nowae/libkicad/README.md

# libkicad
KiCad 4.0.x Library

KiCad 5.0.x Library

For drawing rules, read file [RULES.md](https://github.com/nowae/libkicad/blob/master/RULES.md)
