nowae/libkicad/RULES.md

# Drawing Rules for KiCad 5

## Symbol Editor

Symbol Name and Reference Field text size: 1.27 mm [50 mils]

Pin Lenght: 2.54 mm [100 mils]

Pin Name text size: 1.27 mm [50 mils]

Pin Number text size: 1.27 mm [50 mils]

Power Symbol text size: 1.016 mm [40 mils]

## Footprint Editor
Text Width: 0.8 mm

Text Height: 0.8 mm

Text Thickness: 0.15 mm

Line segment thickness: 0.15 mm
