nowae/libkicad/CONTENTS.md

Library
|-- Schematic
|   |-- Power
|   |   |-- +12V
|   |   |-- +24V
|   |   |-- +24VISO
|   |   |-- +24VISO1
|   |   |-- +24VISO2
|   |   |-- +3.3V
|   |   |-- +3.3VISO
|   |   |-- +5V
|   |   |-- +5VISO
|   |   |-- +5VISO1
|   |   |-- +5VISO2
|   |   |-- +5VISO3
|   |   |-- +V
|   |   |-- -5V
|   |   |-- GND
|   |   |-- GND-3V3-ISO
|   |   |-- GND-3V3-ISO1
|   |   |-- GND-3V3-ISO2
|   |   |-- GND-5V-ISO
|   |   |-- GND-5V-ISO1
|   |   |-- GND-5V-ISO2
|   |   |-- GND-5V-ISO3
|   |   |-- GND-EARTH
|   |   |-- GND-EARTH-1
|   |   |-- GND1
|   |   |-- GNDISO
|   |   |-- GNDISO1
|   |   |-- GNDISO2
|   |
|   |-- Analog
|   |   |-- LTC2622
|   |   |-- MAX31855
|   |
|   |-- Battery Charger
|   |   |-- LTC4067
|   |   |-- MCP73831
|   |
|   |-- Buzzer
|   |   |-- BUZZER
|   |   |-- PKLCS1212E4001-R1
|   |
|   |-- Capacitor
|   |   |-- CAPACITOR
|   |   |-- CAPACITOR_POL
|   |
|   |-- Connector
|   |   |-- CONN_12X1
|   |   |-- CONN_12X2
|   |   |-- CONN_2X1 
|   |   |-- CONN_3X1
|   |   |-- CONN_4X1
|   |   |-- CONN_5X2
|   |   |-- CONN_6X1
|   |   |-- CONN_8X1
|   |   |-- DB9
|   |   |-- MICROSD-MOLEX:473092651
|   |   |-- MICROUSB-629105150521
|   |   |-- USB_B_180-5787834-1
|   |   |-- XBEE-SOCKET
|   |
|   |-- Crystal
|   |   |-- 32768Hz_CM7V-T1A
|   |   |-- ABM7-12.000MHZ
|   |   |-- ABM7-16.000MHZ
|   |
|   |-- DcDc
|   |   |-- TEL3-2411
|   |   |-- TME2405S
|   |   |-- TES1-2411
|   |   |-- TSR0.5-2433
|   |   |-- TSR1-2433SM
|   |   |-- TSR1-2450SM
|   |   |-- TSRN1-2450SM
|   |
|   |-- Development Board
|   |   |-- XMC4700-RELAX
|   |
|   |-- Diode
|   |   |-- BYM10-1000
|   |   |-- CD0603-SO180R
|   |   |-- CDSOT23-SM712
|   |   |-- MBR0520
|   |   |-- MBRS2040L
|   |   |-- MMBD7000LT1G
|   |   |-- MMSZ4684T1G
|   |   |-- PESD12VL2BT
|   |   |-- PESD1CAN
|   |   |-- RS1M
|   |   |-- SK36A
|   |   |-- SM15T39CA
|   |   |-- SMBJ48A-13-F
|   |
|   |-- Fuse
|   |   |-- 0155003.DRT
|   |   |-- FUSE
|   |
|   |-- Inductor
|   |   |-- FERRITE_BEAD
|   |   |-- INDUCTOR
|   |   |-- TCK-044
|   |
|   |-- Led
|   |   |-- CLV1A-FKB (RGB)
|   |   |-- GREEN
|   |   |-- RED
|   |   |-- YELLOW
|   |
|   |-- Logic
|   |   |-- DRV8804DW
|   |   |-- DS3231
|   |   |-- SN65HVS882
|   |   |-- SN74LV14A
|   |   |-- VN808CM-E
|   |
|   |-- Microcontroller
|   |   |-- ATSAM3X8E
|   |   |-- MKL15Z128VLH4
|   |   |-- MK64FN1M0VDC12
|   |   |-- MK64FN1M0VLL12
|   |
|   |-- Miscellaneous
|   |   |-- AMCA31-2R450G-S1F-T (ANTENNA)
|   |   |-- SMALL_JUMPER
|   |   |-- SMALL_JUMPER_3
|   |   |-- TEST_POINT
|   |
|   |-- Operational Amplifier
|   |   |-- OPA2132U
|   |   |-- OPA2314
|   |   |-- SI8920BC-IP
|   |
|   |-- Optoisolator
|   |   |-- ISO7241M
|   |   |-- ISO7340FC
|   |   |-- ISO7341C
|   |   |-- ISO7341FC
|   |   |-- ISO7421
|   |
|   |-- Regulator
|   |   |-- MIC5205-3.3
|   |   |-- REF3312AIDB
|   |   |-- SPX3819-3.3
|   |
|   |-- Resistor
|   |   |-- 3224J-1-103E
|   |   |-- 3224J-1-104E
|   |   |-- CAT16-103J4LF
|   |   |-- CAT16-104J4LF
|   |   |-- MMA0204-1K2
|   |   |-- MMB0207-56
|   |   |-- RESISTOR
|   |   |-- VARISTANCE
|   |
|   |-- Sensor
|   |   |-- FXAS21002C
|   |   |-- FXOS8700CQ
|   |   |-- MMA8451Q
|   |   |-- MPL3115A2
|   |   |-- SFH5711
|   |   |-- Si7021-A20
|   |
|   |-- Switch
|   |   |-- EVQPE104K
|   |
|   |-- Transceiver
|   |   |-- FT230XS
|   |   |-- SN65HVD888
|   |   |-- TJF1051T
|   |   |-- TJF1052IT
|   |
|   |-- Transistor
|   |   |-- BCW66
|   |   |-- IRLML6402
|   |   |-- Si2333DDS
|   |   |-- ZVN4210G
|   |
|   |-- Wireless
|       |-- ZVN4210G
|
|-- Footprint
|   |-- BATTERY-HOLDERS
|   |   |-- KEYSTONE-1042P
|   |   |-- KEYSTONE-3002
|   | 
|   |-- BUZZER
|   |   |-- BUZZER-PKLCS-SERIES
|   |
|   |-- CAPACITOR
|   |   |-- CAPACITOR-6.3x5.3
|   |   |-- CAPACITOR-6.3x7.7
|   |   |-- CAPACITOR-8.0x6.2
|   |   |-- CAPACITOR-8.0x10.0
|   |   |-- CAPACITOR-0402
|   |   |-- CAPACITOR-0603
|   |   |-- CAPACITOR-0805
|   |   |-- CAPACITOR-1206
|   |
|   |-- CONNECTOR
|   |   |-- CONN-SOCKET-12x2-2.54
|   |   |-- CONN-STRIP-4x1-2.54
|   |   |-- CONN-STRIP-5x2-1.27-SMD
|   |   |-- CONN-XBEE-THT
|   |   |-- CONN-XBEEPRO-THT
|   |   |-- DB9_FEMALE_V
|   |   |-- DB9_MALE_V
|   |   |-- MICROUSB-WURTH-WRCOM
|   |   |-- SDCARD-MOLEX-0473092651
|   |   |-- USB-TECON-5787834_1
|   |
|   |-- CONNECTOR_MCV
|   |   |-- CONN-MCV0.5_3-G-2.5
|   |   |-- CONN-MCV0.5_4-G-2.5
|   |   |-- CONN-MCV0.5_8-G-2.5
|   |   |-- CONN-MCV0.5_12-G-2.5
|   |   |-- CONN-MCV1.5_3-G-3.81
|   |   |-- CONN-MCV1.5_4-G-3.81
|   |   |-- CONN-MCV1.5_8-G-3.81
|   |
|   |-- CRYSTAL
|   |   |-- CRYSTAL-1206
|   |   |-- CRYSTAL-ABM7
|   |
|   |-- DIODE
|   |   |-- DIODE-SOD123
|   |   |-- DIODE-DO214AA-UNI
|   |   |-- DIODE-DO214AB-BID
|   |   |-- DIODE-DO214AB-UNI
|   |   |-- DIODE-DO214AC-UNI
|   |
|   |-- DFN
|   |   |-- DFN6_3.0x3.0_1.0
|   |   |-- DFN12+1_3.0x4.0_0.5
|   |
|   |-- DIP
|   |   |-- DIP8-SMD
|   |
|   |-- FUSE
|   |   |-- FUSE-LITTELFUSE-SMT
|   |
|   |-- INDUCTOR
|   |   |-- INDUCTOR-0402
|   |   |-- INDUCTOR-0603
|   |   |-- INDUCTOR-0805
|   |   |-- INDUCTOR-TCK044
|   |
|   |-- LEDs
|   |   |-- LED-0402
|   |   |-- LED-0603
|   |   |-- LED-0805
|   |   |-- LED-1206
|   |
|   |-- LQFP
|   |   |-- LQFP64_10x10_0.5
|   |   |-- LQFP144_20x20_0.5
|   |
|   |-- MECHANICAL
|   |   |-- FIDUCIAL-TOP
|   |   |-- SCREW-M2
|   |   |-- SCREW-M2.5
|   |   |-- SCREW-M3
|   |   |-- SCREW-M4
|   |
|   |-- MISC
|   |   |-- JUMPERSMD-3
|   |   |-- SENSOR-SFH5711
|   |   |-- TESTPOINT-1MM
|   |
|   |-- RESISTOR
|   |   |-- RESISTOR-0402
|   |   |-- RESISTOR-0603
|   |   |-- RESISTOR-0805
|   |   |-- RESISTOR-1206
|   |   |-- RESISTOR-CAT16-X4
|   |   |-- RESISTOR-TRIM-BOURNS-3224J
|   |
|   |-- SOIC
|   |   |-- POWERSO-36_11.0x15.9_0.65
|   |   |-- SOIC8_3.9x4.9_1.27
|   |   |-- SOIC14_3.9x8.7_1.27
|   |   |-- WSOIC16_7.4x10.1_1.27
|   |
|   |-- SOT
|   |   |-- SOT23-3
|   |   |-- SOT23-3-GSD
|   |   |-- SOT23-5
|   |   |-- SOT223
|   |
|   |-- SSOP
|   |   |-- MSOP8_3x3_0.65
|   |   |-- SSOP16_3.9x4.9_0.635
|   |
|   |-- SWITCH
|   |   |-- SWITCH-EVQPE1
|   |
|   |-- TRACOPOWER
|   |   |-- TRACO-TES1-XXXX
|   |   |-- TRACO-TES3-XXXX
|   |   |-- TRACO-TSR0.5-24XX
|   |   |-- TRACO-TSRN1-XXXXSM
|   |
|   |-- WIFI
|   |   |-- ANTENNA-AMCA31
|   |   |-- WIFI-SPWF01XX
