nowae/libkicad/3dmodels/Download_STP_171960501 (rev1).stp

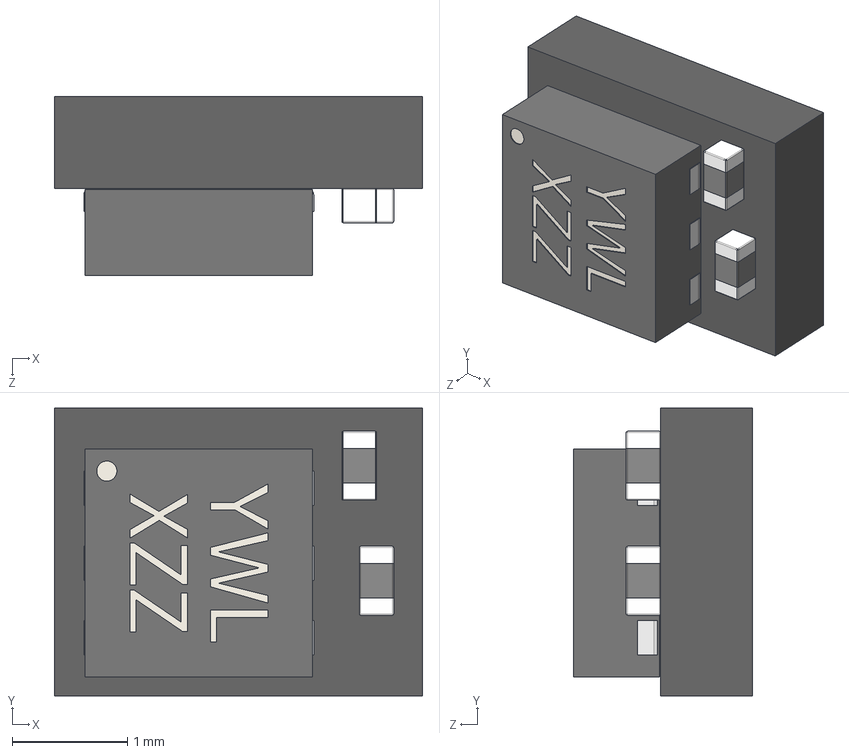
[picture p1: CAD file, 2023-07-04]
3dmodels/Download_STP_171960501 (rev1).stp
3.20 x 2.50 x 1.56 mm
contacts
substrate
contacts_2
QFNBODY
Ferrite x 2
