nowae/libkicad/(threads)

Thread 1 (2017-12-18):

Error in CAPACITOR 16.0x17.0

norlandini, 2017-12-18:
Pins on F.Fab to fix

Closed 2018-03-02.

Thread 2 (2017-12-21):

Error in CAPACITOR 10.0x10.5

norlandini, 2017-12-21:
Pins on F.Fab to fix

Closed 2018-03-02.

Thread 7 (2018-02-22):

The 3d doesn't match the real dimension

warcomeb, 2018-02-22:
https://github.com/nowae/libkicad/blob/67caa983c4b418fb2e63761aed015b6c25e33886/modules/RELAY.pretty/RELAY-JSSERIES-1FORMA.kicad_mod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

Thread 8 (2018-02-22):

The 3d doesn't match the real dimension or silkscreen is wrong

warcomeb, 2018-02-22:
https://github.com/nowae/libkicad/blob/67caa983c4b418fb2e63761aed015b6c25e33886/modules/RELAY.pretty/RELAY-JTNSERIES-1FORMA.kicad_mod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

Thread 11 (2018-03-06):

Missing 3d for RELAY-MEDER-KTXX1A40LTHT

norlandini, 2018-03-06:
Missing 3d models for RELAY-MEDER-KTXX1A40LTHT

Thread 12 (2018-03-06):

Missing 3d for RELAY-MEDER-KTXX1A40LSMD

norlandini, 2018-03-06:
Missing 3d models for RELAY-MEDER-KTXX1A40LSMD

Thread 14 (2018-06-04):

batterycharger/BQ24040DSQT footprint is wrong

norlandini, 2018-06-04:
Modified footprint association from SON:WSON10_3.0x3.0_0.5_10+1 to SON:WSON10_2.0x2.0_0.4_10+1

Closed 2018-06-04.

Thread 17 (2018-10-23):

Missing 3D models for RESISTOR-1210

norlandini, 2018-10-23:
https://github.com/nowae/libkicad/blob/60facbea3e09babe457bff9c9c2e3e7f0f719369/modules/RESISTOR.pretty/RESISTOR-1210.kicad_mod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

Closed 2018-11-08.

Thread 20 (2018-12-18):

Check Polarity-Key

warcomeb, 2018-12-18:
https://github.com/nowae/libkicad/blob/c752d6f76047a87e1d929d4be167aa1856e1990e/modules/CONNECTOR.pretty/M2_2230-TE-2199119-4.kicad_mod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

There are different polarity key for the same connector

warcomeb, 2018-12-18:
See: [datasheet](https://www.te.com/commerce/DocumentDelivery/DDEController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)
