nowae/libkicad/(commit log)

2016-09-15 Added some power symbols, added TJF1051T and TJF1052IT transceivers, added TSR1-2433SM dc-dc converter, added XBEE socket into connector library and added MMSZ4684T1G diode.
2016-09-17 Added MMA8451Q, SFH5711 and Si7021 sensor, added PESD1CAN diode and DB9 connector.
2016-09-17 Added DS3231 (RTC device) into logic library and BCW66 transistor.
2016-09-18 Added 3224J-1-103E and 3224J-1-104E trimmer, added REF3312 voltage reference, added TES3-2422 DC/DC converter, added LM358 operational amplifier and added some power supply labels.
2016-10-02 Added MCP73831 battery charger; added CONN_12x2, MICROSD-MOLEX:473092651 and USB_B_180-5787834-1 connector; added ABM7-12.000MHZ crystal; added TES1-2411 and TSR0.5-2433 DC/DC converter; added MBRS20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
2016-10-08 Added capacitor footprint 0402, 0603, 0805 and 1206.
2016-10-08 Added resistor footprint 0402, 0603, 0805 and 1206.
2016-10-08 Added leds footprint 0402, 0603, 0805 and 1206.
2016-10-08 Added diode footprint SOD123
2016-10-08 Added SOIC footprint library with SOIC14_3.9x8.7_1.27
2016-10-08 Added WSOIC16_7.4x10.1_1.27 footprint into SOIC library
2016-10-09 Added footprint library CONNECTOR_MCV with CONN-MCV1.5_3-G-3.81 and CONN-MCV1.5_8-G-3.81
2016-10-12 Added TRACOPOWER library with TRACO-TSR0.5-24XX footprint
2016-10-13 Small fix on footprint for MCV connector
2016-10-13 Added footprint for DO214AB packages for unidirectional and bidirectional diodes
2016-10-17 Added DIP footprint library with DIP8-SMD
2016-10-18 Added POWERS0-36_11.0x15.9_0.65 footprint into SOIC library.
2016-10-18 Added CAPACITOR-6.3x7.7 and CAPACITOR-8.0x6.2 into CAPACITOR library.
2016-10-19 Created inductor footprint library with INDUCTOR-TCK044
2016-10-20 Added SOIC8_3.9x4.9_1.27 footprint
2016-10-20 Added SOT footprint library with SOT23-3 and SOT23-3-GSD
2016-10-20 Added SSOP footprint library with SSOP16_3.9x4.9_0.635
2016-10-21 Added CONN-MCV0.5_3-G-2.5 e CONN-MCV0.5_8-G-2.5 footprint
2016-10-22 Added DIODE-SMB footprint
2016-10-22 Added SOT23-5 and SOT223 footprint into SOT library
2016-10-22 Added CONN-5x2-1.27-SMD footprint into CONNECTOR library
2016-10-22 Changed DIODE-SMB footprint in DIODE-DO214AA-UNI
2016-10-22 Added LQFP footprint library with LQFP64_10x10_0.5 and LQFP144_20x20_0.5
2016-10-22 Added CRYSTAL footprint library with CRYSTAL-1206 and CRYSTAL-ABM7
2016-10-22 Added RESISTOR-TRIM-BOURNS-3224J footprint
2016-10-22 Added MSOP8_3x3_0.65 footprint
2016-10-22 Added QFN footprint library with QFN16_3x3_0.5 and QFN16_3x3_0.5_5+3
2016-10-22 Added DFN footprint library with DFN6_3.0x3.0_1.0 and DFN12+1_3.0x4.0_0.5
2016-10-24 Updated DB9 MALE connector and added DB9 FEMALE connector. Added DB9_FEMALE_V and DB9_MALE_V footprints in CONNECTOR library.
2016-10-24 Updated description of DB9_FEMALE and DB9_MALE connectors.
2016-11-05 Fixed VN808CM-E pin into schematich library: 0 pin changed to TAB.
2016-11-05 Fixed silksreen into POWERSO-36_11.0x15.9_0.65 component
2016-11-05 Fixed pin of MMBD7000LT1G schematich component
2016-11-05 Fixed borderline of DIODE-SOD123 footprint
2016-11-07 Fixed silkscreen dimension: from 0.2 to 0.15
2016-11-12 Added CONN-MCV0.5_12-G-2.5 footprint
2016-11-12 Added CONN-XBEE-THT and CONN-XBEEPRO-THT footprint into CONNECTOR library
2016-11-12 Added MISC library with JUMPERSMD-3 footprint
2016-11-12 Added TESTPOINT-1MM (example distributor code is RS:262-2179) footprint into MISC library
2016-11-12 Added CONN-MCV0.5_4-G-2.5 footprint into CONNECTOR_MCV library
2016-11-12 Added BUZZER footprint library with BUZZER-PKLCS-SERIES
2016-11-12 Added SENSOR-SFH5711 footprint into MISC library. Right now there isn't a better place.
2016-11-12 Added TRACO-TES3-XXXX footprint into TRACOPOWER library
2016-11-13 Removed hole from footprint: isnt't usefull for the assembling
2016-11-13 Added TRACO-TES1-XXXX footprint into TRACOPOWER library
2016-11-13 Added MICROUSB (WURTH) and USB type B vertical (TE CONNECTIVITY) connector footprint
2016-11-13 Added silkscreen
2016-11-14 Added TRACO-TSRN1-XXXXSM footprint into TRACOPOWER library
2016-11-14 Added JUMPERSMD-2 footprint into MISC library
2016-11-15 Added SK36A schematich components
2016-11-15 Added DIODE-DO214AC-UNI footprint into DIODE library
2016-11-15 Removed wrong named footprint
2016-11-15 Added M2, M2.5 and M3 screws in MECHANICAL.pretty.
2016-11-16 Added CONN-12x2-2.54-BERG footprint into CONNECTOR library
2016-11-16 Added FUSE footprint library with FUSE-LITTELFUSE-SMT
2016-11-16 Added footprint CAPACITOR-8.0x10.0: doesn't change anything compared to 8.0x6.2, only the 3D model for the height.
2016-11-16 Added CONN-MCV1.5_4-G-3.81 footprint into CONNECTOR_MCV library
2016-11-17 Created BATTERY-HOLDERS footprints library with KEYSTONE-3002 and added 3D model for this footprint
2016-11-17 Added SCREW-M4 footprint into MECHANICAL library
2016-11-17 Added 3D model for connector 12x2 socket
2016-11-17 Added resistor pack RESISTOR-CAT16-X4 footprint into RESISTOR library with 3D models
2016-11-17 Added footprint CAPACITOR-6.3x5.3: doesn't change anything compared to 6.3x7.7, only the 3D model for the height.
2016-11-17 Added 3D models for the capacitors added before
2016-11-17 Added INDUCTOR-0402, INDUCTOR-0603 and INDUCTOR-0805 footprint
2016-11-17 Added SWITCH footprint library with SWITCH-EVQPE1
2016-11-17 Changed name of CONN-12x2-2.54-BERG footprint to CONN-SOKET-12x2-2.54
2016-11-17 Changed name of CONN-5x2-1.27-SMD footprint to CONN-STRIP-5x2-1.27-SMD
2016-11-17 Added CONN-STRIP-4x1-2.54 footprint into CONNECTOR library
2016-11-17 Some fix on CONN-STRIP-5x2-1.27-SMD footprint
2016-11-17 Fix pin number on MCP73831
2016-11-17 Added SDCARD-MOLEX-0473092651 footprint into CONNECTOR library
2016-11-17 Added 3D model for screw
2016-11-18 Added KEYSTONE-1042P footprint into BATTERY-HOLDERS library
2016-11-18 Added FIDUCIAL-TOP footprint into MECHANICAL library
2016-12-09 Fix footprint: deleted extra lines
2016-12-09 Fix footprint: added silkscreen line for first pin
2016-12-15 Added WIFI footprint library with ANTENNA-AMCA31 and WIFI-SPWF01XX
2016-12-15 Added MK64FN1M0VLL12 schematic coomponent
2016-12-17 Added RN4870 in schematic component (wireless.lib).
2016-12-19 Added MK64FN1M0VDC12 schematich component into microcontroller library
2016-12-20 Added MAPBGA121 footprint into BGA library (new library) with 3D model
2017-01-22 Added LMZ34002, LMZ35003 and TPS62180 in switching library (ohilab-switching).
2017-01-23 Added TPS62743 in switching library.
2017-01-31 Renamed all files of schematich library
2017-01-31 Changed defined KIOHILABMOD to KINOWAEMOD into footprint where 3D model is selected
2017-02-10 Centered value of RESISTOR symbol
2017-02-12 Added USB_A_90 in connectors library
2017-02-12 Added blue led on led library
2017-02-12 Created nowae-driver library and added TPS92511 and FLS0116
2017-02-12 Added US1M in diodes library
2017-02-21 Added FRDM-KL25Z development board
2017-02-21 Moved VCCIO pin of FT230XS into better position
2017-02-25 Removed footprints filter in nowae-capacitor.lib
2017-02-25 Removed resistor footprint filter in nowae-resistor.lib
2017-02-25 Added footprints filter in nowae-capacitor.lib
2017-02-25 Added resistor footprint filter in nowae-resistor.lib
2017-02-25 Added footprint filter for FT230XQ in nowae-transceiver.lib
2017-02-25 Added footprint filter in TPS62743
2017-02-25 Added footprint filter for IRLML6402 in nowae-transistor.lib
2017-02-25 Added footprint filter of inductance in nowae-inductor.lib
2017-03-01 Small fix for FRDM-KL25Z schematich component
2017-03-01 Added TPS62153 schematich component into switching library
2017-03-01 Added MKDS1_2-3.81 footprint into new library CONNECTOR_MKDS
2017-03-01 Added 3D model for footprint CONN-MKDS1_2-3.81
2017-03-01 Fix on footprint filters os some schematich components
2017-03-01 Added CONN-1x1 schematich component
2017-03-03 Added CONN-FRDM footprint into CONNECTOR library. It is useful when in the board is present a NXP freedom board.
2017-03-06 Added TPS62152 in nowae-switching.lib
2017-03-06 Added USB A plug smd in connector.pretty
2017-03-06 Added pin 17 (exposed thermal pad) in TPS62153. Added footprint filter
2017-03-06 Added TDK SPM3012 Inductor footprint
2017-03-08 Added component reference into FAB layer for QFN16_3x3_0.5_16+1 footprint
2017-03-08 Added component reference into FAB layer for JUMPERSMD-2 and JUMPERSMD-3 footprint
2017-03-08 Updated footprint filter for FT230X-S
2017-03-09 Added description and footprint filter for RN4870 in nowae-wireless.lib Added nowae-wireless.dcm
2017-03-22 Added MKDS1_4-3.81 footprint into library CONNECTOR_MKDS
2017-04-10 Fixed package filter of FT230X in nowae-transceiver.lib
2017-04-13 Added reference (pin 1) in QFN16_3x3_0.5_16+1 in QFN.pretty
2017-04-13 Modified 3D model in CONN-MKDS1_4-3.81 in CONNECTOR_MKDS.pretty
2017-04-13 Added pin 32-33 in RN4870U in WIFI.pretty
2017-04-15 Added logo in nowae.kicad_wks
2017-05-24 Added GND-24V-ISO in power.lib. Added description of GND-24V-ISO in power.dcm.
2017-05-29 Modified REF3312 in nowae-regulator.lib
2017-05-29 Added schematic library for relay, with IM07TS of TE Connectivity.
2017-05-30 Updated pin dimension of IM07TS relay
2017-06-05 Added schematic symbols for ULN2803ADW and TPL7407LD into transistor library
2017-06-05 Added schematic symbol for SN74LVC16373ADGGR into logic library
2017-06-09 Added schematic symbols for Harting connector 09031646921, Ethernet connector RB1-125BAG1A form WIZnet
2017-06-09 Added schematic symbols for resistor pack of 1.5kohm and 33ohm
2017-06-09 Added schematic symbols for KSZ8081RNACA of Microchip into transceiver library
2017-06-09 Added schematic symbol for ABM7-25.000MHZ into crystal library
2017-06-13 Added schematic symbols for MK64FN1M0VLQ12 of NXP into microcontroller library
2017-06-13 Added schematic symbol for 3-input AND SN74LVC1G11DBV into logic library
2017-06-13 Added schematic symbol for 4 vie dip-switch MCDHN-04F of multicomp
2017-06-26 Added DIODE-DO41 in DIODE.pretty with 3d model
2017-06-26 Added -5VISO and -3.3VISO in power.lib
2017-06-26 Modified text of GND-5V-ISO (+5V ISO -> 05V ISO) in power.lib
2017-07-03 Removed power supply in LM358 (part b) in nowae-opamp.lib
2017-07-19 Added REF3325 in nowae-regulator.lib with description in nowae-regulator.dcm
2017-07-21 Fixed LM358 in nowae-opamp (removed power supply from unit b)
2017-07-24 Added FXLN8372Q in nowae-sensor.lib with description in nowae-sensor.dcm
2017-07-31 Added ES1CL in nowae-diode.lib and description in nowae-diode.dcm
2017-07-31 Added voltage reference REF1930 in nowae-regulator.lib and description in nowae-regulator.dcm
2017-07-31 Added 03V3, 012V and 024V signals in power.lib
2017-08-02 Added SN6505BDBVT schematich component into regulator library
2017-08-02 Added micro SD connector 693071010811 of wurth elektronik into connector library.
2017-08-02 Added diode 1N5819 into nowae-diode.lib. Added description into nowae-diode.dcm.
2017-08-02 Updated 1N5819HW-7-F in nowae-diode.lib
2017-08-02 Added ST1S14PHR into nowae-switching.lib. Added description into nowae-switching.dcm.
2017-08-03 Added schematich component BAV70L into nowae-diode.lib
2017-08-03 Added schematich component MCDHN-08F into switch library
2017-08-03 Added schematich component SN74LVC1G332BVD into logic library
2017-08-03 Added schematich component TS3A4741DGKR into switch library: is an analog switch.
2017-08-03 Added footprint HSOIC8_3.9x4.9_1.27 into SOIC.pretty
2017-08-03 Added footprint SOT23-6 in SOT.pretty with 3d model
2017-08-04 Added schematich component CURRENTTRANSFORMER-TALEMA:AC1200 into inductor library
2017-08-04 Added footprint TQFN20_5x5_0.65_20+1 into QFN.pretty with 3d model (qfn-20)
2017-08-04 Added footprint filter for MAX31865 in nowae-analog.lib
2017-08-05 Added footprint QFN12_3x3_0.65 in QFN.pretty
2017-08-05 Modified footprint filter for INA333 into nowae-opamp.lib
2017-08-05 Added footprint filter for ST1S14PHR into nowae-switching.lib
2017-08-05 Added footprint filter for SN6505BDBVT into nowae-regulator.lib
2017-08-05 Added footprint filter for REF1930 into nowae-regulator.lib
2017-08-05 Added footprint filter for LM358 in nowae-opamp.lib
2017-08-05 Added footprint filter for FXLN8372QR1 in nowae-sensor.lib
2017-08-05 Added RMB4S into nowae-diode.lib
2017-08-05 Added footprint DIODE-TO269AA into DIODE.pretty
2017-08-06 Added footprint for TJF1052IT into nowae-transceiver.lib
2017-08-06 Fixed footprint for ST1S14PHR and TPS62152 into nowae-switching.lib
2017-08-06 Fixed footprint for INA333 into nowae-opamp.lib
2017-08-06 Fixed footprint for RMB4S into nowae-diode.lib
2017-08-06 Added description for RMB4S into nowae-diode.dcm
2017-08-06 Added footprint INDUCTOR-7050 into INDUCTOR.pretty
2017-08-06 Added footprint TRANSFORMER-750315371 into INDUCTOR.pretty
2017-08-06 Added footprint TRANSFORMER-AC1200 into INDUCTOR.pretty
2017-08-06 Added footprint information for CURRENTTRANSFORMER-TALEMA:AC1200 into nowae-inductor.lib
2017-08-06 Added footprint CAPACITOR-5.0x5.5 in CAPACITOR.pretty
2017-08-07 Renamed TRANSFORMER-AC1200 in CURRENTTRANSFORMER-AC1200 into INDUCTOR.pretty
2017-08-07 Added footprint information for LM358D in nowae-opamp.lib
2017-08-07 Added footprint DIODE-0603 in DIODE.pretty
2017-08-07 Added footprint SDCARD-WURTH-693071010811 in CONNECTOR.pretty
2017-08-07 Fixed CAPACITOR-5.0x5.5 into CAPACITOR.pretty
2017-08-07 Fixed CURRENTTRANSFORMER-AC1200 into INDUCTOR.pretty
2017-08-07 Fixed SDCARD-WURTH-693071010811 into CONNECTOR.pretty
2017-08-07 Added footprint CONN-STRIP-2x1-2.54 into CONNECTOR.pretty
2017-08-07 Added footprint CONN-STRIP-3x1-2.54 into CONNECTOR.pretty
2017-08-07 Added footprint LQFP100_14x14_0.5_100+1 in LQFP.pretty
2017-08-07 Fixed footprint information in XMC4500-F100x1024 into nowae-microcontroller.lib
2017-08-08 Added schematich symbol for CAT16-102J4LF component
2017-08-08 Added schematich component for SN74LVC1G04DBV, SN74LVC1G08DBV and VN330SP-E into logic library.
2017-08-08 Added schematich component for MMSZ4689T1G into diode library
2017-08-08 Added schematich component for ETH-WURTH:74990101210 into connector library
2017-08-09 Associated 3d model for CONN-STRIP-2x1-2.54 in CONNECTOR.pretty
2017-08-09 Added connector 20x2
2017-08-09 Added schematich component CONN_HARTING:09051486921 into connector library
2017-08-10 Added schematich component SMBJ100CA into diode library
2017-08-10 Added schematich components TLV2316IDGK and TLV316IDBV into opamp library
2017-08-10 Added schematich component TLV2316IDR into opamp library (this component is different from the previous commit because the footprint change)
2017-08-11 Added schematich components CONN_15x2, CONN_30x1 and DB44_MALE_90-TECONN:5749771-1 into connector library
2017-08-11 Added schematich components for TS4148-RYG into diode library and NE555D into logic library
2017-08-11 Added footprint VSSOP8_3x3_0.65 in SOP.pretty with 3d model
2017-08-11 Added 3d model for TESTPOINT-1MM into MISC.pretty
2017-08-11 Modified footprint for INA333 into nowae-opamp.lib
2017-08-11 Added schematich components TPS60400DBV and TPS79718DCK into regulator library
2017-08-11 Fixed GND-3V3-ISO and GND-5V-ISO into power.lib
2017-08-12 Fixed information on RMB4S into diode library
2017-08-13 Added schematich component for ESD8V0L2B-03L into diode library, but it is discontinued
2017-08-14 Added schematich component for TSR1-2450 into DC-DC library
2017-08-15 Added 3d model for DIODE-TO269AA into DIODE.pretty
2017-08-15 Added footprint KEYSTONE-3001 with 3d model into BATTERY-HOLDERS.pretty
2017-08-15 Added pin 21 for MAX31865 in nowae-analog.lib
2017-08-15 Added footprint for BREAKOUT-LINE in MECHANICAL.pretty
2017-08-22 Updated footprint QFN16_3x3_0.5_16+1 into QFN.pretty (increased via dimensions)
2017-08-22 Updated footprint KEYSTONE-3001 into BATTERY-HOLDERS.pretty
2017-08-22 Added footprint HOLE-M2 into MECHANICAL.pretty
2017-08-22 Added generic footprint CURRENT-TRASFORMER-AC1xxx into INDUCTOR.pretty
2017-08-22 Added footprint filter
2017-08-22 Added POWERSO-10_7.5x9.4_1.27 into SOIC.pretty
2017-08-23 Added footprint SC70-6 into SC70.pretty with 3d model
2017-08-23 Added schematich symbols for MBRA340T3G and BZG03C30TR into diode library, and COMMONMODEFILTER-WURTH:744282100 into inductor library
2017-08-24 Added schematich symbols STM1816TWX7F into logic library and TPS54232D into switching library
2017-08-24 Added schematich symbols for TPS54160ADGQ into switching library and ES2C, SS26FL into diode library
2017-08-24 Added relay footprint library with IM07TS footprint and 3D model
2017-08-25 Added SOIC16_3.9x9.9_1.27 footprint into SOIC library
2017-08-25 Added 3D model for LQFP144 footprint
2017-08-25 Added schematich symbol NC7WZ14EP6X into logic library
2017-08-25 Added schematich symbol for TPL7407LPW into transistor library
2017-08-25 Added footprints for TSSOP48 and TSSOP16 with 3D models
2017-08-29 Added 5x1 connector
2017-08-29 Added schematich symbol for PESD3V3L2BT into diode library, TLV2172IDR into opamp library and REF1933AIDD into regulator library
2017-08-30 Added schematich symbol for TPS61041DBVR into switching library
2017-09-01 Added footprint for MCV1.5_2-G-3.81 and MCV1.5_5-G-3.81 in CONNECTOR.MCV.pretty
2017-09-02 Added footprint TRACO-TEL3-XXXX in TRACOPOWER.pretty
2017-09-04 Added +13VISO and +14VISO power symbols
2017-09-05 Added 3d models (from wurth elektronik web site) for MCV1.5 series connector footprint
2017-09-05 Added 3d model for Wurth 693071010811 SDCard connector
2017-09-05 Added foorprint filter for ES2C symbol
2017-09-05 Added footprint for TRACO-TSR1 component with 3d model
2017-09-05 Added footprint for Wurth USB Connector, model 61400413321, with 3d model
2017-09-05 Fixed TRACO-TEL3-XXXX footprint and added 3d model
2017-09-05 Added footprints MSOP10_3x3_0.5 and MSOP10_3x3_0.5_10+1 with 3d model into SOP.pretty
2017-09-06 Added footprint for Wurth connector 687330124422 with 3d model
2017-09-06 Added schematich symbol for SMD dip switch 416131160808 by wurth and added footprint and 3d model for this component, added footprint and 3d model for smd dip switch 8p of omron A6H-810x or multicomp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
2017-09-07 Fixed assembly line of footprint
2017-09-07 Added CAPACITOR-12.5x14.0 with 3d model into CAPACITOR.pretty
2017-09-07 Added CAPACITOR-10.0x10.5 with 3d model into CAPACITOR.pretty
2017-09-08 Added footprint for DIODE-DO214AA-BID into diode library
2017-09-08 Added footprint and 3d model for lightpipe from Dialight (PN: 5151049F) into mechanical library
2017-09-08 Added footprint and 3d model of DSUB 44p from TE (PN: 5749771-1) into CONNECTOR_DSUB library
2017-09-11 Fixed holes dimension
2017-09-11 Added footprint and 3d model of Harting connector 09031646921
2017-09-13 Fixed SN6505 into nowae-regulator.lib
2017-09-15 Fixed pin numer
2017-09-16 Fixed MICROSD-WURTH:693071010811 into nowae-connector.lib
2017-09-19 Fixed footprint SDCARD-WURTH-693071010811 into CONNECTOR.pretty
2017-09-22 Added description of -5VISO into power.dcm
2017-09-23 Added schematich symbol TEN3-2411N into dc-dc library
2017-09-23 Added footprint TRACO-TEN3N-XXXX
2017-09-26 Added footprint USB-A-WURTH-614004135023 into CONNECTOR.pretty with 3d model
2017-09-26 Added footprint TESTPOINT-1MM-SMD into MISC.pretty
2017-09-26 Modified pin 1 of USB-A-WURTH-614004135023 into CONNECTOR.pretty
2017-09-26 Added footprint USB-A-WURTH-61400416021 into CONNECTOR.pretty with 3d model
2017-09-26 Added schematich symbol for CONN_14x1 into connector library
2017-09-27 Added footprint INDUCTOR-WURTH-1210 into INDUCTOR.pretty with 3d model
2017-09-27 Fixed footprint USB-A-WURTH-61400416021 into CONNECTOR.pretty
2017-09-27 Fixed footprint USB-A-WURTH-614004135023 into CONNECTOR.pretty
2017-09-27 Added schematic symbol USB_A-180-WURTH:614004135023 into nowae-connector.lib with description
2017-09-28 Removed 3d model for TESTPOINT-1MM-SMD into MISC.pretty
2017-09-30 Removed solderpaste layer from TESTPOINT-1MM-SMD into MISC.pretty
2017-09-30 Added 3d model for footprint SOP4_7.5x4.1_2.54 into SOP.pretty
2017-10-01 Added BQ24072 into nowae-batterycharger with description
2017-10-03 Added BQ25100 into nowae-batterycharger.lib with description
2017-10-04 Added footprint INDUCTOR-WURTH-1030 into INDUCTOR.pretty with 3d model
2017-10-09 Added schematich symbol for FXLS8471Q into sensor library
2017-10-11 Added schematich symbol for ORG1410-PM04 and ORG1510-R02 GPS modules into wireless library
2017-10-12 Added footprint CAPACITOR-16.0x17.0 into CAPACITOR.pretty with 3d model
2017-10-12 Added footprint DPAK-2 into PAK.pretty with 3d model
2017-10-12 Added footprint DPAK-5 into PAK.pretty with 3d model
2017-10-12 Added schematich symbol for BGM111A256V2 into wireless library.
2017-10-14 Fixed footprint DIODE-TO269AA into DIODE.pretty
2017-10-17 Added footprint SSOP4_4.4x2.6_1.27 into SOP.pretty with 3d model
2017-10-17 Fixed footprint SSOP4_4.4x2.6_1.27 into SOP.pretty
2017-10-19 Added symbol HOLE-M3 into MECHANICAL.pretty
2017-10-20 Updated 3d model of ZIF-WURTH-687330124422 into CONNECTOR-ZIF.pretty
2017-10-22 Added CONNECTOR_40X2 into nowae-connector.lib with description
2017-10-24 Added footprint USB-3.0-A-WURTH-692141030100 into CONNECTOR.pretty with 3d model
2017-10-24 Added connector USB-3.0-A-WURTH-692141030100 into nowae-connector.lib with description
2017-10-24 Added schematics symbols for: - WURTH HDMI connector inside connector library - PCA9306 and 74AVC1T45GW into logic library - PTN3363 into tranceiver library
2017-10-25 Added footprint CONN-S3053-V-2-3.81 into CONNECTOR_WR-TBL.pretty with 3d model
2017-10-25 Added footprint CONN-S3053-V-3-3.81 into CONNECTOR_WR-TBL.pretty with 3d model
2017-10-25 Added footprint CONN-S3053-V-4-3.81 into CONNECTOR_WR-TBL.pretty with 3d model
2017-10-25 Added footprint CONN-S3053-V-5-3.81 into CONNECTOR_WR-TBL.pretty with 3d model
2017-10-25 Added footprint CONN-S3053-V-6-3.81 into CONNECTOR_WR-TBL.pretty with 3d model
2017-10-25 Added footprint CONN-S3053-V-7-3.81 into CONNECTOR_WR-TBL.pretty with 3d model
2017-10-25 Added footprint CONN-S3053-V-8-3.81 into CONNECTOR_WR-TBL.pretty with 3d model
2017-10-25 Added footprint CONN-S3053-V-12-3.81 into CONNECTOR_WR-TBL.pretty with 3d model
2017-10-27 Added footprint ETHERNET-WURTH-615008140421 into CONNECTOR.pretty with 3d model
2017-10-28 Added schematich symbol for MKL25Z128VLH4 into microcontroller library
2017-10-31 Added symbols +1.8VA, +1.8VS, +3.3VA and +3.3VS into power.lib with descriptions
2017-10-31 Added symbol TPS22918 into nowae-switch.lib with description
2017-10-31 Added symbols M.2_2230 and M.2_2242 into nowae-connector.lib with descriptions
2017-11-05 Added TPS54541DPRT into nowae-switching.lib with description
2017-11-08 Added footprint DIPSWITCH-4P-WURTH-416131160804 into SWITCH.pretty with 3d model
2017-11-08 Updated footprint CAPACITOR-0603 into CAPACITOR.pretty
2017-11-08 Updated footprint RESISTOR-0603 into RESISTOR.pretty
2017-11-09 Modified footprint POWERSO-36_11.0x15.9_0.65 into SOIC.pretty. Added 3d model.
2017-11-10 Added symbol CONN_4x2 into nowae-connector.lib with description
2017-11-10 Updated footprint MICROUSB-WURTH-WRCOM into CONNECTOR.pretty. Added 3d model.
2017-11-14 Added symbol barrel jack into nowae-connector.lib with description
2017-11-14 Added symbol SS22 into nowae-diode.lib with description
2017-11-14 Fixed SS22 description into nowae-diode.dcm
2017-11-14 Fixed symbol barrel jack into nowae-connector.lib
2017-11-14 Added symbol TPS61087 into nowae-switching.lib with description
2017-11-14 Added schematich symbol for Wurth ethernet connector 7499511440 into connector library
2017-11-16 Added schematich symbol for TSR1-2433 into dc-dc library
2017-11-16 Added schematich symbol for MK10DX64VLH7 into microcontroller library
2017-11-16 Added some power symbols and 0154375.DRT symbol into fuse library
2017-11-16 Added schematich symbol for L78L12ACU into regulator library
2017-11-18 Added schematich symbol for PEM3012 into transceiver library
2017-11-18 Added schematich symbol TCMT1100 into opto library
2017-11-18 Added shematich symbol for REF3320AIDB, TLV70233DBV and TLV74333PDBVR into regulator library
2017-11-20 Added footprint TRACO-TMR6-XXXX into TRACOPOWER.pretty with 3d model
2017-11-20 Added SOT89-3 footprint and 3d model
2017-11-20 Fixed footprint TRACO-TMR6-XXXX into TRACOPOWER.pretty
2017-11-20 Added footprint and 3dmodel for CONN-MCV0.5_2-G-2.5 of phoenix contact
2017-11-20 Added footprint and 3d model for DIODE-1206 and DIODE-0805
2017-11-20 Added footprint and 3d models of INDUCTOR-WURTH-1210In, that is a 1210 (imperial system) inductor
2017-11-22 Fixed pin number
2017-11-22 Fixed FAB text and added 3d model for MCV0.5_4_G-2.5 footprint
2017-11-24 Added symbol +VBAT into power.lib with description
2017-11-24 Fixed footprint FIDUCIAL-TOP into MECHANICAL.pretty
2017-11-24 Fixed footprint QFN16_3x3_0.5_16+1 and 3d ratio into QFN.pretty
2017-11-24 Fixed footprint QFN16_3x3_0.5 and 3d ratio into QFN.pretty
2017-11-25 Added schematich symbol for FDV304P into transistor library
2017-11-25 Added schematich symbol TS4148-RXG into diode library and fixed TS4148-RYG informations
2017-11-25 Added value on F.Fab layer for footprint LQFP100_14x14_0.5_100+1 into LQFP.pretty
2017-11-25 Added value on F.Fab layer for footprint SOP4_7.5x4.1_2.54 into SOP.pretty
2017-11-25 Added value on F.Fab layer on footprint DIP8-SMD into DIP.pretty
2017-11-25 Modified value position on F.Fab layer for footprint LQFP100_14x14_0.5_100+1 into LQFP.pretty
2017-11-27 Added schematich symbol for TS5A3159DCK into switch library
2017-11-29 Fixed footprint informations
2017-11-30 Added footprint for capacitor 1210 with 3d model
2017-11-30 Updated footprint informations
2017-11-30 Added footprint and 3d model for HDMI connector 685119134923 of wurth
2017-11-30 Added footprint INDUCTOR-WURTH-CNSW-0805 into INDUCTOR.pretty with 3d model
2017-11-30 Added footprint INDUCTOR-WURTH-CNSW-1206 into INDUCTOR.pretty with 3d model
2017-11-30 Added footprint WSON10_3.0x3.0_0.5_10+1 into SON.pretty with 3d model
2017-12-01 Added footprint and 3d model for Ethernet connector 7499511440 of Wurth Elektronik
2017-12-04 Added license for official KiCAD repository into packages3D
2017-12-04 Added footprint VSSOP8_2.4x2.1_0.5 with 3d model into SOP.pretty
2017-12-04 Updated footprint SC70-6 into SC70.pretty
2017-12-04 Updated associate footprint for 74AVCH1T45GW into nowae-logic.lib
2017-12-05 Added 3d model for HVQFN32_5x5_0.5_32+1 into modules/packages3d/kicad/QFN
2017-12-05 Added footprint HVQFN32_5x5_0.5_32+1 into QFN library
2017-12-06 Added schematich symbol for MK12DX256VLH5 into microcontroller symbol
2017-12-06 Added footprint and 3d model for STRIP_5x2_1.27_SMD-AMPHENOL-20021521_00010T1LF
2017-12-06 Added footprints M2_2230-TE-2199119-4 and M2_2242-TE-2199119-3 into CONNECTOR.pretty
2017-12-07 Added directory BUTTON.pretty into fp-lib-table
2017-12-07 Added footprint BUTTON-WE-436353045816 with 3d model into BUTTON.pretty
2017-12-07 Added footprint BUTTON-WE-434123043816 with 3d model into BUTTON.pretty
2017-12-09 Added footprint CONN-HRS-DF40C-80DS-0.4V(51) with 3d model into DF40C-80DS-0.4V(51)
2017-12-09 Fixed position value on F.Fab layer forfootprint BUTTON-WE-434123043816 into BUTTON.pretty
2017-12-09 Fixed position value on F.Fab layer for footprint BUTTON-WE-436353045816 into BUTTON.pretty
2017-12-09 Fixed position value on F.Fab layer for footprint M2_2230-TE-2199119-4 into CONNECTOR.pretty
2017-12-09 Fixed position value on F.Fab layer for M2_2242-TE-2199119-3 into CONNECTOR.pretty
2017-12-09 Added layer F.CrtYd for CONN-HRS-DF40C-80DS-0.4V(51) into CONNECTOR.pretty
2017-12-09 Added layer F.CrtYd for BUTTON-WE-436353045816 into BUTTON.pretty
2017-12-09 Added layer F.CrtYd for BUTTON-WE-434123043816 into BUTTON.pretty
2017-12-09 Added footprint BARRELJACK-WE-694106301002 with 3d model into CONNECTOR.pretty
2017-12-11 Updated footprint VSSOP8_2.4x2.1_0.5 into SOP.pretty
2017-12-11 Moved EVQPE1 footprint into button library
2017-12-12 Added footprint for PEM30XX PoE module into MISC library
2017-12-13 Added footprint INDUCTOR-WURTH-7332Plastic with 3d model into INDUCTOR.pretty
2017-12-13 Fixed symbol SPX3819-3.3 into nowae-regulator.lib
2017-12-13 Added symbol NSR2030QMUTAG with description into nowae-diode.lib
2017-12-14 Added footprint QFN32_5x5_0.5_32+1 into QFN.pretty
2017-12-14 Added footprint QFN20_4x4_0.5_20+1 into QFN.pretty
2017-12-14 Fixed thermal pad for footprint QFN16_3x3_0.5_16+1 into QFN.pretty
2017-12-14 Fixed thermal pad for footprint QFN16_4x4_0.65_16+1 into QFN.pretty
2017-12-14 Fixed thermal pad for footprint TQFN20_5x5_0.5_20+1 into QFN.pretty
2017-12-14 Added footprint HOLE_M3.5 into MECHANICAL.pretty
2017-12-15 Added file kicad_common into utility directory
2017-12-15 Added kicad common configuration in script install-library-linux into utility directory
2017-12-15 Removed wrong footprint filter for CD0603-S01180R into nowae-diode.lib
2017-12-15 Added footprint LQFP48_7x7_0.5 with 3d model into LQFP.pretty
2017-12-15 Added footprint CRYSTAL-CSTCE into CRYSTAL.pretty
2017-12-15 Added footprint ANTENNA-MOLEX-47948-0001 with 3d model into ANTENNA.pretty
2017-12-16 Added 3d model for footprint SDCARD-MOLEX-0473092651 into CONNECTOR.pretty
2017-12-16 Fixed footprint USB-3.0-A-WURTH-629141030100 into CONNECTOR.pretty
2017-12-19 Fixed footprint WSON10_3.0x3.0_0.5_10+1 into SON.pretty
2017-12-20 Added 3d model for CONN-XBEE-THT into CONNECTOR.pretty
2017-12-20 Added footprint INDUCOTR-WE-SCC-1260 with 3d model into INDUCTOR.pretty
2017-12-20 Added footprint BALUN-2450BM14A0002T into ANTENNA.pretty
2017-12-20 Added footprint and 3d model of battery holder 79548211 by Wurth Elektronik
2017-12-21 Added footprint UDFN4_3.5x3.5_1.55 into DFN.pretty
2017-12-21 Added footprint BUTTON-WS-PBSU with 3d model into BUTTON.pretty
2017-12-21 Added footprint DIP8-THT with 3d module into DIP.pretty
2018-01-02 Fixed footprint QFN32_5x5_0.5_32+1 into QFN.pretty
2018-01-02 Updated footprint and 3d model for M2_2242-TE-2199119-3 into CONNECTOR.pretty
2018-01-03 Added schematich symbol for MKL15Z128VLK4 into microcontroller lib
2018-01-03 Fixed symbol NSR2030QMUTAG into nowae-diode.lib
2018-01-03 Fixed footprint UDFN4_3.5x3.5_1.55 into DFN.pretty
2018-01-04 Fixed footprint BALUN-2450BM14A0002T into ANTENNA.pretty
2018-01-08 Added schematich symbol for NTC thermistor into resistor library
2018-01-08 Added schematich symbol for SFH3711 of OSRAM into transistor library
2018-01-08 Added schematich symbol for SPU0410HR5H into sensor library
2018-01-09 Removed filter for symbol FERRITE_BEAD into nowae-inductor.lib
2018-01-09 Added layer F.Fab for footprint M2_2230-TE-2199119-4 into CONNECTOR.pretty
2018-01-09 Added footprint and 3dmodel of BUTTON-WE-WS_TATU_083 into button library
2018-01-09 Fixed buzzer schematich symbols dimension and added schematich symbol PKMCS0909E4000
2018-01-09 Added footprint CONN-TAGCONNECT-TC2050-10-NL into CONNECTOR.pretty
2018-01-10 Added footprint STRIP_10x1_2.00_SMD-WE-62001011121 with 3d model into CONNECTOR.pretty
2018-01-10 Added symbol CONN_10X1 with description into nowae-connector.lib
2018-01-10 Renamed footprint
2018-01-10 Added footprint and 3dmodel of 61000821121 and 61201020621 by wurth elektronik into connector library
2018-01-10 Added footprint and 3dmodel of 62001011821 by wurth elektronik into connector library
2018-01-10 Added symbol IR2110SPBF with description into nowae-driver.lib
2018-01-10 Added symbols +5VA, -5VA and +5VD with descriptions into power.lib
2018-01-10 Added footprint and 3d model for SMM-110-02-S-S of samtec into connector library
2018-01-10 Renamed STRIP_10x1_2.00-WE-62001011821 into SOCKET_10x1_2.00-WE-62001011821
2018-01-10 Added schematich symbol for led rgb 150121M173000 of Wurth Elektronik
2018-01-11 Fixed FDV304P schematich symbol
2018-01-11 Added symbol +VBOOST with description into power.lib
2018-01-11 Added schematich symbol BUTTON-WE:431181015816 into switch library
2018-01-12 Added symbol LM2776DBVR with description into nowae-switching.lib
2018-01-16 Added schematich symbol for 434121043816 by Wurth Elektronik into switch library
2018-01-16 Added footprint and 3d models of 150080M173000 and 150121M173000 by Wurth Elektronik
2018-01-16 Added footprint and 3d model of 4311810158x6 by Wurth Elektronik into button library
2018-01-17 Added symbol STPS30170DJF-TR with description into nowae-diode.lib
2018-01-17 Added symbol REF3330AIDBZT with description into nowae-regulator.lib
2018-01-17 Added symbol DIPSWITCH-MULTICOMP:MCDHN-06F with description into nowae-switch.lib
2018-01-17 Updated symbol FXOS8700CQ into nowae-sensor.lib
2018-01-17 Added schematich symbol for pcb touch button BUTTON-TOUCH-1P into switch library
2018-01-17 Added schematich symbols for MKL15Z128VFM4 and MKL15Z64VFM4 into microcontroller library
2018-01-17 Added footprints QFN24_4x4_0.5 and QFN24_4x4_0.5_7+5 with 3d models into QFN.pretty
2018-01-17 Added schematich symbol 150080M173000, led rgb by Wurth Elektronik
2018-01-17 Added footprint for touch button BUTTON-TOUCH-1P-CIRCLE-5MM
2018-01-17 Added footprint for SPU0410HR5H into misc library
2018-01-17 Fixed footprint informations of TLV70233DBV schematich symbol
2018-01-18 Added footprint and 3d model for BUZZER-PKMCS-SERIES into buzzer library
2018-01-19 Added symbol MMSZ18ET1G into nowae-diode.lib
2018-01-19 Added symbol PI3305-00-LGIZ into nowae-switching.lib
2018-01-19 Added footprint and 3d model of SFH3711 sensor by Osram
2018-01-20 Fixed footprint HVQFN32_5x5_0.5_32+1 into QFN.pretty
2018-01-22 Added symbol AIM1714VB6MC7D5T00 with description into nowae-diode.lib
2018-01-22 Added symbol 3224J-1-502E with description into nowae-resistor.lib
2018-01-22 Added symbol PFM4414VB6M24D0T00 with description into nowae-regulator.lib Added footprint for TLV70233DBV into nowae-regulator.lib
2018-01-23 Added symbol UC3845D8G4 with description into nowae-driver.lib
2018-01-24 Added schematich symbol for Molex connector 0877159206
2018-01-24 Added schematich symbol for generic 7x1 connector
2018-01-24 Added usefull schematich power symbols: +24 (1 to 4) and GND (1 to 4)
2018-01-25 Added footprint that represent the board for 5650118-2 connector of TE
2018-01-25 Added schematich symbol, footprint and 3d of 434153017835 button by Wurth Elektronik
2018-01-25 Fixed datasheet link for CD0603-S0180R into nowae-diode.dcm
2018-01-25 Added JST footprint library with B5B-PH-SM4-TB footprint and 3d model
2018-01-26 Added BOM fields into generic components
2018-01-26 Added schematich symbol of OKI-78SR-5/1.5-W36-C into dc/dc library
2018-01-26 Added footprint and 3d model of OKI-78SR Series by Murata Power
2018-01-26 Added symbol IM03PNS with description into nowae-relay.lib
2018-01-28 Added footprints and 3d models of B3B-PH-SM4, B4B-PH-SM4 and B7B-PH-SM4 by JST
2018-01-28 Added schematich symbol of 10x2 generic connector
2018-01-29 Created CONNECTOR_MOLEX library for footprint, added footprint ad 3d model of 877159206 by Molex, updated fp-lib-table with new library
2018-02-01 Fixed symbol MBR0520 into nowae-diode.lib Added symbol WE-TVS-82400102 with description into nowae-diode.lib
2018-02-01 Added symbol +VE with description into power.lib
2018-02-01 Fixed symbol USB_A-180-WURTH:614004135023 into nowae-connector.lib
2018-02-01 Added footprint association for KSZ8081RNA into nowae-transceiver.lib
2018-02-02 Added footprint CRYSTAL-ABM10 with 3d into CRYSTAL.pretty
2018-02-04 Added symbol SMAJ58A-TR with description into nowae-diode.lib
2018-02-05 Added symbol IM23TS with description into nowae-relay.lib
2018-02-05 Added footprint ETHERNET-WURTH-74990101210 with 3d model into CONNECTOR.pretty
2018-02-05 Fixed footprint ETHERNET-WURTH-74990101210 into CONNECTOR.pretty
2018-02-05 Added footprint WE-SIP3 with 3d module into MAGI3C-FSDM.pretty
2018-02-05 Added symbol TLV1117-50CDCY into nowae-regulator.lib
2018-02-05 Fixed footprint WE-SIP3 into MAGI3C-FSDM.pretty
2018-02-05 Added footprint QFN24_4x4_0.5_24+1 into QFN.pretty
2018-02-05 Added footprint CRYSTAL-TSX3225 with 3d model into CRYSTAL.pretty
2018-02-05 Added schematich symbol of JS1a-24V-F relay by Panasonic
2018-02-06 Added footprint and 3d model for S2B-PH-K-S by JST
2018-02-06 Added schematich symbol JTN1ASPAF24 by Panasonic into relay library
2018-02-06 Added schematich symbol for 9x1 connector
2018-02-06 Added schematich symbol for RTD14024 relay by TE
2018-02-06 Added schematich symbol BZT52C3V3-7-F and CDSOD323-T05C into diode library
2018-02-06 Added schematich symbol 431256083716 by Wurth Elektronik into switch library
2018-02-07 Added footprint and 3d model for B8B-PH-SM4-TB by JST
2018-02-07 Added footprint and 3d model of B9B-PH-SM4-TB by JST
2018-02-07 Added footprint of JS series relay by Panasonic, 1 form C type and 1 form A type
2018-02-07 Added footprint and 3d model of SOD323 package into DIODE library
2018-02-07 Added footprint and 3d model of RT1 relay by TE Connectivity, model 1formC 16A and 1formA 16A.
2018-02-07 Added footprint of JT-N relay by Panasonic, 1 form A type
2018-02-07 Added schematich symbol for AM26C32IPW by Texas Instruments into transceiver library
2018-02-07 Added schematich symbol of ST485BDR by STM into transceiver library
2018-02-07 Added footprint for SOD323 bidirectional
2018-02-07 Added footprint ETHERNET-WURTH-615008137421 with 3d model into CONNECTOR.pretty
2018-02-09 Added footprint and 3d model of Keystone terminal 8191
2018-02-09 Added schematich symbols for shunt CRA2512-FZ-R100ELF by Burns into resistor library, and terminal 8191 by Keystone into connector library
2018-02-09 Added footprint and 3d model of 1881639 connector by Phoenix Contact
2018-02-09 Added footprint MOLEX-ULTRAFIT-1723161210 with 3d model into CONNECTOR.pretty
2018-02-09 Fixed footprint SCREW-M4 into MECHANICAL.pretty
2018-02-09 Changed 3d settings for RESISTOR-0603 into RESISTOR.pretty
2018-02-09 Changed 3d settings for RESISTOR-0805 into RESISTOR.pretty
2018-02-09 Changed 3d settings for LED-0805 into LEDs.pretty
2018-02-09 Added footprint for TCMT1100 into nowae-opto.lib
2018-02-09 Changed 3d settings for CAPACITOR-0805 into CAPACITOR.pretty
2018-02-09 Added footprint MAGIC-FDSM-SIP-3 with 3d models into MAGI3C-FSDM.pretty
2018-02-12 Fixed footprint and 3d model of MCV 0.5/2.5 connector series by Phoenix Contact
2018-02-12 Fixed pin name
2018-02-13 Added footprint, 3d model and step file for MCV1.5/4-GF-3.81 connector by Phoenix Contact
2018-02-13 Added footprint, 3d and step file for resistor 2512
2018-02-13 Fixed pin on switch component
2018-02-13 Fixed symbol +3.3V, +5V, +5VA, +VBAT, +VBOOST, -5VA, GND1 into power.lib
2018-02-13 Fixed symbol +24V into power.lib
2018-02-13 Added footprint HARTING-09061486901 with 3d models into CONNECTOR-HARTING.pretty
2018-02-13 Added symbol BQ24040DSQT into nowae-batterycharger.lib
2018-02-15 Fixed symbol +VE and GND-ANALOG-0 into power.lib
2018-02-15 Fixed symbol GND1 into power.lib
2018-02-15 Added symbol CONN_HARTING:09061486901 with description into nowae-connector.lib
2018-02-20 Added footprint PAD_THT_2.5x5.0 into MISC.pretty
2018-02-20 Added footprint PAD_THT_3.5x6.0 into MISC.pretty
2018-02-20 Added footprint PAD_THT_3.0x5.5 into MISC.pretty
2018-02-20 Added footprint and 3d model for TO220-2 package
2018-02-21 Fixed footprint LQFP100_14x14_0.5 into LQFP.pretty
2018-02-22 Added 3d model of JTN series relay. FIXME: maybe the silkscreen is not correct in position
2018-02-22 Added 3d model to JS series relay. FIXME: the 3d doesn't match the real dimension of the relay
2018-02-22 Added footprint and 3d model of MKDS3 (2 and 3 pole) connector by Phoenix Contact
2018-02-23 Added footprint for custom inductor designed by Elettromeccanica Taddei
2018-03-02 Added symbol CONN_HARTING:09061486901 and DB15_MALE with description into nowae-connector.lib
2018-03-02 Fixed symbol DB15_MALE into nowae-connector.lib
2018-03-02 Fixed footprint CAPACITOR-16.0x17.0 into CAPACITOR.pretty (issue #1)
2018-03-02 Fixed footprint CAPACITOR-10x10.5 into CAPACITOR.pretty. (issue #2) Added 3d model for CAPACITOR-10x10.5 into 3rd-party/wurth.
2018-03-02 Added footprint DSUB15-M-WURTH-61801529221 with 3d models into CONNECTOR_DSUB.pretty
2018-03-02 Added symbol CONN_16X1 with description into nowae-connector.lib
2018-03-02 Added footprint ETHERNET-WURTH-615008137421 into CONNECTOR.pretty
2018-03-02 Fixed symbol STPS30170DJF-TR into nowae-diode.lib
2018-03-05 Added footprint SOIC18_7.6x11.7_1.27 with 3d model into SOIC.pretty (missing step file) (issue #9)
2018-03-05 Added footprint SOIC16_7.6x10.5_1.27 with 3d models into SOIC.pretty
2018-03-05 Fixed footprint SOIC16_7.6x10.5_1.27 into SOIC.pretty
2018-03-05 Added footprint CONN-MCV1.5_8-G-5.08 with 3d models into CONNECTOR.MCV.pretty (issue #10)
2018-03-05 Added footprint CONN-MCV1.5_3-G-5.08 with 3d models into CONNECTOR_MCV.pretty
2018-03-05 Added footprint TDSON8_5.1x5.9_1.27 with 3d models into SON.pretty
2018-03-05 Added footprint RESISTOR-WSR5 into RESISTOR.pretty
2018-03-05 Added footprint MURATA-NMEXXXXSC with 3d models into MURATAPOWER.pretty
2018-03-05 Added footprint CAPACITOR-18x25_7.5 with 3d models into CAPACITOR.pretty
2018-03-06 Added footprint CONN-MKDS3_3-5.08_WO-CENTRAL into CONNECTOR_MKDS.pretty
2018-03-06 Added symbol KT24-1A-40L-THT and KT24-1A-40L-SMD with description into nowae-relay.lib
2018-03-06 Added footprint RELAY-MEDER-KTXX1A40LTHT without 3d models into RELAY.pretty
2018-03-06 Added footprint RELAY-MEDER-KTXX1A40LSMD without 3d models into RELAY.pretty
2018-03-06 Added footprint XPPOWER-F02-F60 with 3d models into XPPOWER.pretty
2018-03-06 Added footprint ROTARYENCODER-EC12E2424407 with 3d model (no step file) into ROTARY-ENCODER.pretty
2018-03-21 Added schematich symbol REL-SR-24DC/2X21/FG by Phoenix Contact into relay library
2018-03-21 Added schematich symbol for 20x1 and 34x1 simple connectors
2018-03-21 Added footprint and 3d model of relay 2908777 by Phoenix Contact
2018-03-21 Added footprint and 3d model of MCD 0,5/10-G1-2,5 connector by Phoenix Contact
2018-03-21 Added footprint and 3d model for 1456129 connector by Phoenix Contact into new category CONNECTOR_MTYPE
2018-03-21 Added footprint association
2018-03-22 Fixed locking hole with metal one
2018-03-22 Added footprint and 3d model of samtec IDC connector EHF-108-01-F-D-SM-LC and EHF-108-01-F-D-SM
2018-03-22 Added footprint and 3d model of IDC connector by Samtec: EHF-117-01-F-D-SM-LC and EHF-117-01-F-D-SM
2018-03-23 Changed hole dimension
2018-03-27 Added Fab text on footprint
2018-03-28 Added footprint and 3d model of CIF 2.4 connector by ILME
2018-03-28 Added schematich symbol for 0154004.DRT into fuse library
2018-03-29 Added symbols CONN_17x2, CONN_32x2, CONN_40x1 and CONN_8x2 with description into nowae-connector.lib
2018-03-29 Added footprint and 3d models of SPTAF 1/9-3,5-EL and SPTAF 1/8-3,5-EL by Phoenix Contact
2018-03-29 Added assembly text on footprint
2018-03-29 Fixed attribute for ZIF-WURTH-687330124422 into CONNECTOR_ZIF.pretty
2018-03-30 Added footprint and 3d models of PTSA0.5/14-2.5-Z PTSA0.5/12-2.5-Z and PTSA0.5/3-2.5-Z by Phoenix Contact
2018-03-30 Added footprint and 3d model of SPTAF 1/9-3,5-EL by Phoenix Contact
2018-03-30 Added footprint and 3d model of SPTAF 1/10-3,5-EL by Phoenix Contact
2018-04-03 Fixed path for CONNECTOR_DSUB.pretty into fp-lib-table
2018-04-03 Added footprint STRIP_20x2_2.54-WE-61304021121 with 3d models into CONNECTOR.pretty
2018-04-03 Added footprint STRIP_32x2_2.54-WE-61306421121 with 3d models into CONNECTOR.pretty
2018-04-03 Fixed 3d setup for STRIP_20x2_2.54-WE-61304021121 into CONNECTOR.pretty
2018-04-03 Fixed 3d setup for STRIP_20x2_2.54-WE-61306421121 into CONNECTOR.pretty
2018-04-05 Added footprint STRIP_20x2_2.54_BOTTOM-WE-61304021121 into CONNECTOR.pretty
2018-04-05 Added footprint STRIP_32x2_2.54_BOTTOM-WE-61306421121 into CONNECTOR.pretty
2018-04-06 Added schematich symbol for nanoSMDC020F by Littlefuse into fuse library
2018-04-06 Added schematich symbol for ADG706BRU of Analog Device into logic library
2018-04-09 Added schematich symbol of CD74HC4067SM96 by Texas Instruments into logic library
2018-04-09 Added footprint and 3d models of SSOP24 (DB version of Texas Instruments)
2018-04-09 Added footprint and 3d model of TSSOP28 (PW version by Texas Instruments)
2018-04-10 Added schematich symbols for 50474C, 50105C, 50225C and 50475C by Murata Power Solutions into inductor library. Added footprint and 3d models for these components
2018-04-10 Added schematich symbol of 100616-2 connector by TE Connectivity. Added footprint and 3d model.
2018-04-11 Added schematich symbol for ADG706BRU by Analog Device and fixed other components
2018-04-13 Fixed symbol +V into power.lib
2018-04-13 Added symbol DB9_MALE_DOUBLE with description into nowae-connector.lib
2018-04-16 Added schematich symbol for LM5009AMM by Texas Instruments into switching library
2018-04-18 Added footprint USB-A-WURTH-629004113921 with 3d models into CONNECTOR.pretty
2018-04-18 Fixed footprint RN4870U into WIFI.pretty
2018-04-18 Added symbol USB-A-90-WURTH-629004113921 with description into nowae-connector.lib
2018-04-19 Added footprint ETHERNET-WURTH-7499010121A with 3d models into CONNECTOR.pretty
2018-04-19 Added symbol USB-A-90-WURTH-614104190121 with description into nowae-connector.lib
2018-04-19 Added footprint USB-A-WURTH-614104190121 with 3d models into CONNECTOR.pretty
2018-04-19 Added schematich symbol, footprint and 3d model of led KW DMLN31.SG by Osram.
2018-04-19 Added schematich symbol, footprint and 3d model of SMA-21-S buzzer by SOnitron
2018-04-19 Added schematich symbol, footprint and 3d model of ESB33536 button by Panasonic
2018-04-19 Added footprint for PAD SMD 2x5mm and 2x6mm
2018-04-20 Added footprint for SMD pad 1.7x4.0
2018-04-23 Added schematich symbol, footprint and 3d model of SMD jumper link S1621-46R by Harwin
2018-04-24 Fixed footprint DSUB15-M-WURTH-61801529221 into CONNECTOR.pretty
2018-04-24 Added footprint SOIC6_6.8x4.6_1.27 into SOIC.pretty
2018-04-24 Added footprint SC70-5 with 3d models into SC70.pretty
2018-04-24 Added footprint RESISTOR-CAT10-X4 into RESISTOR.pretty
2018-05-03 Fixed footprint STRIP_20x2_2.54_BOTTOM-WE-61304021121 into CONNECTOR.pretty
2018-05-03 Fixed footprint STRIP_32x2_2.54-WE-61306421121 into CONNECTOR.pretty
2018-05-03 Fixed footprint STRIP_32x2_2.54_BOTTOM-WE-61306421121 into CONNECTOR.pretty
2018-05-04 Added schematich symbol fo dipswitch 416131160804 by Wurth Elektronik into switch library
2018-05-04 Added schematich symbol, footprint and 3d model of dipswitch 416131160802 by Wurth Elektronik
2018-05-04 Fixed component informations on 416131160808 into switch library and added some step files
2018-05-10 Added footprint and 3d model for generic SMD inductor 1806. Added schematich component for BLM41PG102SN1 by Murata into inductor library
2018-05-10 Added schematich symbol for ACM7060-701-2PL and ACM70V-701-2PL common model filter by TDK. Added footprint and 3d model for these inductor
2018-05-10 Added footprint and 3d model for angled strip 61300711021 by WE. It is a generic footprint for this kind of strip.
2018-05-11 Added schematich symbol for PS2911-1 by Renesas into opto library. Added footprint for this component (it is a modified version of standard SSOP4 footprint with a ultra small pin).
2018-05-11 Added schematich symbol of ISL3150EIUZ by Intersil into tranceiver library
2018-05-14 Added footprint and 3d model of SPATF1/2-3.5-EL connector by Phoenix Contact
2018-05-14 Added holes strip footprint 7x1/2.54
2018-05-14 Fixed footprint RESISTOR-CAT10-X4 into RESISTOR.pretty
2018-05-14 Added symbol CAT10-103J4LF with description into nowae-resistor.lib
2018-05-14 Added symbol CAT10-330J4LF with description into nowae-resistor.lib
2018-05-14 Added footprint informations for CAT10-103J4LF and CAT10-330J4LF into nowae-resistor.lib
2018-05-21 Added symbol CONN_18x1 with description into nowae-connector.lib
2018-05-21 Added schematich symbol of CNY64AGRST into opto library. Added footprint and 3d model of SOP4 for high voltage appliactions with pitch between pins of 5.08mm
2018-05-21 Added schematich symbol of 0451001.NRL by Littelfuse and added footprint and 3d model for this fuse.
2018-05-21 Added footprint and 3d model of TDK inductor of SLF10145 series
2018-05-21 Added footprint for screw hole of 4.5mm
2018-05-22 Added pin 1 reference for SOIC16_7.6x10.5_1.27 into SOIC.pretty
2018-05-22 Added footprint CONN-MOLEX-901301108 with 3d models into CONNECTRO_MOLEX.pretty
2018-05-22 Added footprint CONN-MOLEX-901301110 with 3d models into CONNECTOR_MOLEX.pretty
2018-05-22 Added footprint CONN_MOLEX_901301114 with 3d models into CONNECTOR_MOLEX.pretty
2018-05-22 Added footprint CONN_MOLEX_901301116 with 3d models into CONNECTOR_MOLEX.pretty
2018-05-22 Added footprint CONN_MOLEX_901301118 with 3d models into CONNECTOR_MOLEX.pretty
2018-05-22 Added schematich symbol of SI8920BD-IS by Silicon Labs
2018-05-23 Fixed footprints CONN-MOLEX-901301108, CONN-MOLEX-901301110, CONN-MOLEX-901301114, CONN-MOLEX-901301116, CONN-MOLEX-901301118 into CONNECTOR_MOLEX.pretty
2018-05-23 Added footprint information for CAT10-330J4LF into nowae-resistor.lib
2018-05-23 Added footprint association for CAT16 series into nowae-resistor.lib
2018-05-23 Added footprint association for 1N5819HW-7-F into nowae-diode.lib
2018-05-23 Fixed nowae-diode.lib and nowae-diode.dcm
2018-05-24 Added footprint IDC-5x2-2.54-we-61201021621 with 3d models into CONNECTOR_IDC.pretty
2018-05-24 Added schematich symbol for Ethernet connector 1-406541-5 by TE. Added footprint and 3d model of this connector.
2018-05-24 Added footprint and 3d model of 70553-0001 connector by Molex
2018-05-24 Fixed footprint SOT23-3 into SOT.pretty
2018-05-31 Renamed footprint JUMPERSMD-2 into JUMPERSMD-SMALL-2 into MISC.pretty
2018-05-31 Fixed footprint M2_2242-TE-2199119-3 into CONNECTOR.pretty
2018-05-31 Added footprint JUMPERSMD-2 into MISC.pretty
2018-05-31 Added footprint LEDRGB-AVAGO-PLCC4 into LEDs.pretty
2018-05-31 Added footprint LEDRGB-PLCC6 into LEDs.pretty
2018-05-31 Added footprint LEDRGB-WURTH-PLCC4 into LEDs.pretty
2018-05-31 Added footprint LEDRGB-CREE-PLCC4 into LEDs.pretty
2018-05-31 Added symbol ASMB-MTB1-0A3A2 with description into nowae-led.lib
2018-05-31 Added 3d models WL-SFTW-3528 for PLCC4 footprint
2018-05-31 Added footprint CONN_TE_292207-2 with 3d models into CONNECTOR.pretty
2018-05-31 Added footprint RESISTOR-0201 with 3d models into RESISTOR.pretty
2018-05-31 Added footprint TESTPOINT-0.5MM-SMD into MISC.pretty
2018-05-31 Added footprint CAPACITOR-0201 with 3d models into CAPACITOR.pretty
2018-05-31 Added footprint DSUB9-NORCOMP-189009613R571 with 3d models into CONNECTRO_DSUB.pretty
2018-05-31 Added 3d models for CAPACITOR_0402
2018-05-31 Modified 3d models for CAPACITOR-0402 into CAPACITOR.pretty
2018-06-04 Fixed footprint association for BQ24040DSQT into nowae-batterycharger.lib (issue #14)
2018-06-05 Added footprint WSON10_2.0x2.0_0.4_10+1 with 3d models into SON.pretty
2018-06-05 Fixed name and style of schematich component 629105150521 by Wurth
2018-06-05 Added footprint WSON10_4.0x4.0x0.8_10+1 with 3d models into SON.pretty
2018-06-05 Added footprint association for TSP54541DPRT into nowae-switching.lib
2018-06-05 Fixed part number for TPS54541DPRT into nowae-switching.lib and updated price
2018-06-14 Fixed symbol BGM111A256V2 into nowae-wireless.lib
2018-06-14 Added symbols LIS2DW12TR, TMP102AIDRLT, TMP103AYFFT and VCNL3020-GS08 with descriptions into nowae-sensor.lib
2018-06-14 Added footprint and 3d model of SPTAF1/4-3.5-EL connector by Phoenix Contact
2018-06-19 Added schematich symbol, footprint and 3d model of OPI1280-026 by OPTEK Technology
2018-07-08 Added footprint CONN-STRIP-2x1-2.00 into CONNECTOR.PRETTY
2018-07-08 Added footprint CONN-STRIP-3x1-2.00 into CONNECTOR.pretty
2018-07-08 Added 3d models (62000211121) for CONN-STRIP-2x1-2.00 (CONNECTOR.pretty)
2018-07-08 Added 3d models (62000311121) for CONN-STRIP-3x1-2.00 (CONNECTOR.pretty)
2018-07-09 Renamed footprint JUMPERSMD-3 into JUMPERSMD-SMALL-3 into MISC.pretty Added new footprint JUMPERSMD-3 into MISC.pretty
2018-07-09 Fixed footprint JUMPERSMD-2 into MISC.pretty
2018-07-09 Added footprint CONN-STRIP-5x2-1.27 with 3d models (62201021121) into CONNECTOR.pretty
2018-07-10 Added footprint DSUB9-M-V-WURTH-61800929221 with 3d models into CONNECTOR_DSUB.pretty
2018-07-10 Fixed footprint DSUB9-M-V-WURTH-61800929221 into CONNECTOR_DSUB.pretty
2018-07-10 Updated footprint DSUB9-M-V-WURTH-61800929221 into CONNECTOR_DSUB.pretty
2018-07-10 Added footprint CONN-MCV0.5_5-G-2.5 with 3d models (mcv_0.5-5-g-2.5) into CONNECTOR.pretty
2018-07-10 Fixed footprint CONN-MCV0.5_5-G-2.5 into CONNECTOR_MCV.pretty
2018-07-10 Added footprint CONN-MCV0.5_6-G-2.5 into CONNECTOR_MCV.pretty
2018-07-10 Added footprint TSSOP24_4.4x7.8_0.65 with 3d models (TSSOP-PW) into SOP.pretty
2018-07-11 Added footprint RESISTOR-WSHP2818 with 3d models (WSHP2818) into RESISTOR.pretty
2018-07-11 Added footprint RESISTOR-DIN0617-17.0x6.0-5.08 with 3d models (R_Axial_DIN0617_L17.0mm_D6.0mm_P5.08mm_Vertical) into RESISTOR.pretty
2018-07-12 Added footprint CONN-PAD-2x1-1.27 into CONNECTOR.pretty
2018-07-12 Added footprint CONN-PAD-3x1-1.27 into CONNECTOR.pretty
2018-07-12 Added footprint CONN-PAD-5x1-1.27 into CONNECTOR.pretty
2018-07-14 Modified footprint CONN-PAD-2x1-1.27 into CONNECTOR.pretty
2018-07-14 Modified footprint CONN-PAD-3x1-1.27 into CONNECTOR.pretty
2018-07-14 Modified footprint CONN-PAD-5x1-1.27 into CONNECTOR.pretty
2018-07-14 Fixed symbol VCNL3020-GS08 into nowae-sensor.lib
2018-07-16 Added mechanical footprint MENTOR-LIGHT-GUIDE_3MM-1275.1001 into MECHANICAL.pretty
2018-07-25 Added footprint RELAY-TQ2-2FORMC into RELAY.pretty
2018-07-25 Added footprint CONN-SMA-60312002114503 with 3d models (60312002114503) into CONNECTOR.pretty
2018-07-25 Fixed 3d model path for LEDRGB-AVAGO-PLCC4 into LEDs.pretty
2018-07-25 Fixed 3d model path for LEDRGB-CREE-PLCC4 into LEDs.pretty
2018-07-25 Fixed 3d model path for LEDRGB-WURTH-PLCC4 into LEDs.pretty
2018-07-26 Added symbol SMA-180-WURTH-60312002114503 with description into nowae-connector.lib
2018-07-26 Added footprint CONN_40x6_SEAM-40-03.0-S-06-2-A-KTR with 3d models (SEAM-40-03.0-S-06-2-A-K-TR) into CONNECTOR.pretty
2018-07-26 Fixed footprint SOIC18_7.6x11.7_1.27 into SOIC.pretty
2018-07-27 Fixed footprint LEDRGB-PLCC6 into LEDs.pretty Added 3d models WL-SFTW-150352M1xxx into modules/packages3d/3rd-party/wurth
2018-07-27 Added footprint RELAY-IMxxN with 3d modules (modules/packaged3d/3rd-party/te/TE_IMxxN) into RELAY.pretty
2018-07-31 Added footprint INDUCTOR-TDK-ACM90SERIES into INDUCTOR.pretty
2018-07-31 Added footprint HOLE-M2.5 into MECHANICAL.pretty
2018-08-01 Added file sym-lib-table for symbol path configuration (KiCad 5) into utility directory
2018-08-02 Fixed footprint TSSOP14_4.4x5.0_0.6 into SOP.pretty
2018-08-02 Added footprint SIMNANO-WURTH-693043020611 with 3d models (modules/packages3d/3rd-party/wurth/693043020611) into CONNECTOR.pretty
2018-08-02 Fixed footprint SIMNANO-WURTH-693043020611 into CONNECTOR.pretty
2018-08-02 Added footprint HSPA-SARAU2 into WIFI.pretty
2018-08-03 Removed slash symbol from some components name. KiCAD 5 do not support that character
2018-08-03 Added symbol +15VISO and +VUSB into power.lib
2018-08-03 Added footprint HVQFN40_6.0x6.0_0.5_40+1 with 3d modules (modules/packages3d/3rd-party/texas/VQFN40-RHA) into QFN.pretty
2018-08-03 Added symbol SARA-U2 with description into nowae-wireless.lib
2018-08-06 Added footprint CONN_40x8_MOLEX-459704185 with 3d models (459704185) into CONNECTOR.pretty
2018-08-07 Fixed footprint CAPACITOR-12.5x14.0 into CAPACITOR.pretty
2018-08-07 Changed name with ":" symbol to "-" into nowae-connector.lib and nowae-connector.dcm for KiCAD 5.0.0 compatibility
2018-08-08 Fixed symbol description for +VUSB into power.dcm
2018-08-08 Added symbol MMSZ4691T1G with description into nowae-diode.lib
2018-08-09 Modified footprint TDSON8_5.1x5.9_1.27 into SON.pretty
2018-08-09 Fixed symbol GND-ANALOG-0 into power.lib
2018-08-10 Added symbol CONN_SBRIO-9651 with description into nowae-connector.lib
2018-08-10 Added footprint CONN_SBRIO-9651 with 3d models (modules/packages3d/3rd-party/ni/sbrio-9651) into CONNECTOR.pretty
2018-08-10 Added footprint SPACER-M3x10_WURTH-9774100360 with 3d models (modules/packages3d/3rd-party/wurth/9774100360) into MECHANICAL.pretty
2018-08-10 Fixed REF3320AIDB into nowae-regulator.lib
2018-08-10 Fixed datasheet link for USB-A-90-WURTH-614104190121 into nowae-connector.dcm
2018-08-10 Added symbol TPS54561DPRT with description into nowae-switching.lib
2018-08-13 Added footprint BLE-BGM111A256V2 with 3d models (modules/packages3d/nowae/WIFI/BGM111A256V2) into WIFI.pretty
2018-08-20 Added symbol TLV70218DBV with description into nowae-regulator.lib
2018-08-20 Added symbol MAX-M8C with description into nowae-wireless.lib Added footprint association for BGM111A256V2 into nowae-wireless.lib
2018-08-20 Added footprint BUZZER-CUI-CSS-0575A-SMT with 3d models (modules/packages3d/rd-party/cui/CSS-0575A-SMT) into BUZZER.pretty
2018-08-20 Removed symbol MAX-M8C from nowae-wireless.lib
2018-08-20 Added footprint GPS-MAX-M8C into GPS.pretty
2018-08-20 Added footprint GSM-SARAG350 into WIFI.pretty
2018-08-20 Renamed SIMNANO-WURTH-693043020611 into NANOSIM-WURTH-693043020611 into CONNECTOR.pretty
2018-08-20 Added symbol NANOSIM-WURTH-693043020611 with description into nowae-connector.lib
2018-08-20 Added symbol UFL-HIROSE-U.FL-R-SMT with description into nowae-connector.lib
2018-08-21 Added symbol CONN_SBRIO-9607 with description into nowae-connector.lib
2018-08-24 Fixed pin names on CONN_SBRIO-9607
2018-08-24 Added footprint CRYSTAL-ABS06 with 3d models (modules/packages3d/nowae/CRYSTAL) into CRYSTAL.pretty
2018-08-24 Added footprint TSOP6_1.9x2.9_0.95 into SOP.pretty
2018-08-24 Added footprint UDFN8_2.0x3.0_0.5 into DFN.pretty
2018-08-24 Added footprint THERMISTOR-B57238S0 into RESISTOR.pretty
2018-08-24 Added footprint LGA10_2.4x4.9_0.4 into BGA.pretty
2018-08-24 Added footprint LGA12_2x2_0.5 into BGA.pretty
2018-08-24 Added footprint DSBGA4_0.76x0.76_0.4 into BGA.pretty
2018-08-24 Added mechanical footprint for MODULE-SOM-IB3710 into MECHANICAL.pretty
2018-08-24 Added footprint KEYSTONE-3080 with 3d models (modules/packages3d/3rd-party/keystone/3080) into BATTERY-HOLDERS.pretty
2018-08-24 Added footprint CONN-HALF-HOLE-2x1-1.27 into CONNECTOR.pretty
2018-08-27 Fixed origin center for footprint CONN_SBRIO-9651 into CONNECTOR.pretty
2018-08-27 Added footprint CONN_SBRIO-9607 into CONNECTOR.pretty
2018-08-27 Added symbol +1.8V with description into power.lib
2018-08-27 Added symbol LMZ23605TZE_NOPB with description into nowae-switching.lib
2018-08-27 Fixed symbol LMZ23605TZE_NOPB into nowae-switching.lib
2018-08-27 Added symbol RS9113-NBZ-D1x with description into nowae-wireless.lib
2018-08-28 Added symbol DIPSWITCH-WURTH_418121270810 with description into nowae-switch.lib
2018-08-29 Modified ST1S14PHR into nowae-switching.lib
2018-08-29 Added symbol HL7692 with description into nowae-wireless.lib
2018-08-30 Ignored 3d informations for CONN_SBRIO-9607 into CONNECTOR.pretty
2018-08-30 Fixed footprint CONN-SBRIO-9651 into CONNECTOR.pretty
2018-08-30 Ignored 3d informations for CONN_SBRIO-9651 into CONNECTOR.pretty
2018-08-30 Ignored 3d informations for CONN_40x8_MOLEX-459704185 into CONNECTOR.pretty
2018-08-31 Fixed footprint CONN_SBRIO-9607 into CONNECTOR.pretty
2018-08-31 Fixed footprint CONN_SBRIO-9651 into CONNECTOR.pretty
2018-08-31 Fixed footprint LED-0603 into LEDs.pretty
2018-08-31 Added footprint SIERRAWIRELESS-HL7692 into WIFI.pretty
2018-08-31 Modified footprint GSM-SARAG350 and HSPA-SARAU2 into WIFI.pretty for compatibility with KiCad 4.0.x version
2018-08-31 Fixed symbol HL7692 into nowae-wireless.lib
2018-08-31 Added footprint REDPINE-RS9113-Nxx-x1x into WIFI.pretty
2018-09-03 Added footprint association for TXB0108RGYR into nowae-logic.lib
2018-09-03 Added footprint VQFN20_3.5x4.5_0.5_20+1 into QFN.pretty
2018-09-03 Fixed footprint VQFN20_3.5x4.5_0.5_20+1
2018-09-25 Added footprint CRYSTAL_7M into CRYSTAL.pretty
2018-09-25 Added footprint CONN-S322-H-3-3.81 with 3d models (modules/packages3d/3rd-party/wurth) into CONNECTOR_WR-TBL.pretty
2018-10-09 Added schematich symbol of SN74AVC4T774RGY into logic library
2018-10-09 Added symbol TLV75533PDQNR with description into nowae-regulator.lib
2018-10-09 Added 3.3V_DISPLAY, 3.3V_MCU, 3.3V_GPS, 3.3V_GSM, 3.3V_BLE, 1.8V into power.lib Added footprint LGA12_2x2_0.7 into BGA.pretty
2018-10-10 Updated SARA-U2 to SARA-U201 into wireless library
2018-10-10 Hidden footprint field for CAPACITOR symbol into nowae-capacitor.lib
2018-10-10 Hidden footprint field for JUMPER-2 and JUMPER-3 into nowae-misc.lib
2018-10-10 Fixed power.dcm
2018-10-10 Fixed visibility for datasheet and footprint on INDUCTOR component
2018-10-12 Added schematic component for PTDC114EU into transistor library
2018-10-12 Added schematic and footprint symbol for Embedded SIM into connector library. The schematic component is made with commercial informations of Things Mobile.
2018-10-13 Added new schematic version of U.FL-R-SMT-1 from Hirose into connector library. Added footprint and 3D model of this component into new library CONNECTOR_RADIO
2018-10-13 Fixed schematic design of TLV75533PDQNR and added X2SON4 footprint and 3d model
2018-10-14 Added schematic symbol of TLV75533PDBVR(SOT23-5) into regulator library
2018-10-14 Updated schematic component of MAX-M8C with footprint type. Added 3d model of MAX-M8 series, and updated relative footprint.
2018-10-14 Added footprint and 3d model for SOT323-3 (SC70-3) into SOT library
2018-10-15 Added new schematic library display with these components: REX004864AW, REX006432AY and REX09616AW by raystar optronics
2018-10-15 Added schematic component for PCA9306DC by NXP amd fixed PCA9306DP
2018-10-15 Added +VIN power supply symbol and fixed things on +3.3V symbol
2018-10-15 Added footprint DISPLAY-RAYSTAR-REX004864A into DISPLAY.pretty
2018-10-15 Added footprint INDUCTOR-1206 into INDUCTOR.pretty
2018-10-16 Small fix on schematic component of TLV2316IDGK
2018-10-16 Updated footprint DISPLAY-RAYSTAR-REX004864A into DISPLAY.pretty
2018-10-17 Added footprint association for symbol OLED-RAYSTAR-REX004864AWPP3N into nowae-display.lib
2018-10-17 Added 3d model for e-sim footprint
2018-10-17 Added schematic component for 0467.500NR by Littelfuse into fuse library.
2018-10-18 Added footprint reference for 0467.500NR component
2018-10-18 Added symbol BUTTON-WE_434351045816 with description into nowae-switch.lib
2018-10-18 Hidden footprint information visibility into nowae-connector.lib and nowae-misc.lib
2018-10-18 Added schematic components for TXB0106RGYR and TXB0108DQSR into logic library. Added footprint VQFN16_3.5x4.0_0.5 into QFN library
2018-10-18 Added symbol BUTTON-WE_436353045816 with description into nowae-switch.lib
2018-10-18 Fixed symbol BUTTON-WE_436353045816 into nowae-switch.lib
2018-10-18 Moved few LGA footprints from BGA.pretty to LGA.pretty
2018-10-19 Added footprint UQFN10_1.8x1.4_0.4 with 3d models (/packages3d/3rd-party/texas/UQFN10-RSW) into QFN.pretty
2018-10-19 Added footprint BUTTON-WE-434351045816 with 3d models (/packages3d/3rd-party/wurth/434351045816) into BUTTON.pretty
2018-10-22 Added schematic symbol for TPS73501DRV into regulator library
2018-10-22 Added +3.8V and +VDIO symbol into power library
2018-10-22 Fixed text dimension on some schematic components
2018-10-22 Added footprint RESISTOR-1210 into RESISTOR.pretty
2018-10-23 Added 3d models (modules/packages3d/3rd-party/web/resistor-1210) for RESISTOR-1210 (issue #17)
2018-10-23 Foxed footprint RESISTOR-1210 into RESISTOR.pretty
2018-10-23 Added footprint and 3d model of STRIP-BOX_10x2_2.54_SMD-WE-61202020621 and STRIP_5x1_2.54_WE-61300511121 into connector library.
2018-10-23 Added footprints for NOWAE logo
2018-10-23 Added some CC and OSH footprint logos
2018-10-24 Added switch-3pdt
2018-10-24 Added symbol CL12327 with description into nowae-connector.lib
2018-10-24 Added first version of footprint for border half hole 9x1 2.54mm
2018-10-25 Added footprint and 3d model of USON20_4.0x2.0_0.4_20 into SON library
2018-10-25 Fixed pin 33 function into SARA-U201 and SARA-G350 symbols
2018-10-25 Started to develop WSON6_2.0x2.0_0.65_6+1 footprint. It is NOT complete.
2018-10-25 Ended design of WSON6_2.0x2.0_0.65_6+1 footprint and added 3d model
2018-10-25 Fixed footprint CONN-HALFHOLE-9x1-2.54: now it is smaller.
2018-10-29 Added footprint CONN-HALFHOLE-3x1-2.54 into CONNECTOR.pretty
2018-10-29 Fixed symbol CAPACITOR_POL into nowae-capacitor.lib
2018-11-06 Added TPS70933DBV schematic component into regulator library
2018-11-06 Added footprint for OSH logo: 5mm, 15mm, 20mm, 25mm, 30mm and 35mm of width.
2018-11-06 Added footprint for Common Creative BY-SA logo: 5mm, 15mm, 20mm, 25mm and 35mm of width.
2018-11-07 Added footprint INDUCTOR-WURTH-4030 with 3d modules (/modules/packages3d/3rd-party/wurth/WE-MAPI-4030) into INDUCTOR.pretty
2018-11-07 Fixed name of PDTC114EU into transistor library and added schematic component of PDTC123EU
2018-11-07 Added schematic symbols for AMBER-WE-150141AS73100, RED-WE-150141RS73100 and YELLOW-WE-150141YS73100 into less library. Added footprint and 3d model for WL-SMTW-3528 led series.
2018-11-08 Added symbol SS36FA with description into nowae-diode.lib
2018-11-08 Added footprint CONN-HALFHOLE-4x1-2.54 into connector library
2018-11-16 Fixed text dimensions. Changed pin order on some leds.
2018-11-18 Added symbol CONN_45X2 into nowae-connector.lib
2018-11-18 Added CONN-STRIP-5x1-2.54 footprint into CONNECTOR.pretty library
2018-11-20 Added snowflake footprint (just for design purpose)
2018-11-20 Fixed fab layer of CONN-STRIP-5x1-2.54 footprint
2018-11-21 Added CONN-STRIP-5x1-1.27 footprint into CONNECTOR.pretty library
2018-11-21 Fixed CONN-STRIP-4x1-2.54 footprint and added a new version without silkscreen and fab documentation layer
2018-12-12 Added footprint LGA16_9.0x9.0_1.5_16+1 into LGA.pretty
2018-12-13 Added footprint GPS-NEO-M8 with 3d models (/modules/packages3d/3rd-party/ublox/NEO-M8) into GPS.pretty
2018-12-13 Added footprint CONN-MOLEX-532540670 with 3d models (/modules/packages3d/3rd-party/molex/532540670) into CONNECTOR_MOLEX.pretty
2018-12-13 Added footprint CONN-STRIP-6x1.2.00 into CONNECTOR.pretty
2018-12-13 Added footprint CONN-MOLEX-532540870 with 3d models (/modules/packages3d/3rd-party/molex/532540870) into CONNECTOR_MOLEX.pretty
2018-12-13 Added footprint CONN-MOLEX-1726480102 with 3d models (/modules/packages3d/3rd-party/molex/1726480102) into CONNECTOR_MOLEX.pretty
2019-01-04 Added symbol TLV75730PDBVR with description into nowae-regulator.lib
2019-01-04 Added symbol +3.3V1 and +3.3V_SOM into power.lib
2019-01-04 Added symbol CONN_15X1 into nowae-connector.lib
2019-01-04 Added symbol WPMDL1201801 with description into nowae-switching.lib
2019-01-04 Added symbol +3V_GPS into power.lib
2019-01-04 Added symbol +VBAT_GSM into power.lib
2019-01-25 Added symbol SSCDANN030PAAA5 with description into nowae-sensor.lib Added footprint DIP-AN with 3d models (modules/packages3d/3rd-party/honeywell) into SENSOR_HONEYWELL.pretty
2019-01-25 Added footprint JST_SM15B-SRSS-TB with 3d models (modules/packages3d/3rd-party/jst) into CONNECTOR_JST.pretty
2019-01-27 Addded symbol TLV75733PDRVR with description into nowae-regulator.lib Added symbol TPS70633DRVR with description into nowae-regulator.lib
2019-01-27 Fixed footprint INDUCTOR-0402 into INDUCTOR.pretty
2019-01-27 Fixed footprint CONN-MOLEX-532540670 into CONNECTOR_MOLEX.pretty
2019-01-27 Fixed footprint CONN-MOLEX-532540870 into CONNECTOR_MOLEX.pretty
2019-01-27 Added footprint CONN-HRS-DF40C-90DS-0.4V(51) with 3d models (modules/packages3d/3rd-party/hirose/DF40C-90DS-0.4V(51)) into CONNeCTOR.pretty
2019-01-27 Added footprint CONN-HRS-DF40C-90DS-0.4V(51)-ALT into CONNECTOR.pretty
2019-01-27 Added footprint CONN-STRIP-4x2-2.00 with 3d models (modules/packages3d/3rd-party/wurth/62000821121) into CONNECTOR.pretty
2019-01-28 Fixed datasheet link for symbol TPS70633DRVR into nowae-regulator.dcm
2019-02-03 Fixed symbol BQ24040DSQT into nowae-batterycharger.lib
2019-02-03 Fixed symbol TPS61087DRCR into nowae-switching.lib
2019-02-06 Fixed symbol BUTTON-WE_434153017835 into nowae-switch.lib
2019-02-25 Fixed footprint WSON10_2.0x2.0_0.4_10+1 into SON.pretty
2019-02-25 Renamed directory (SENSOR-HONEYWELL.pretty)
2019-03-01 Added symbol CONN_50X2 into nowae-connector.lib
2019-03-05 Added symbol MURS480ET3G with descriptio into nowae-diode.lib
2019-03-05 Added symbol CAT16-330J8LF with description into nowae-resistor.lib
2019-03-15 Fixed footprint VQFN16_3.5x4.0_0.5_16+1 into QFN.pretty
2019-03-15 Added footprint VQFN14_3.5x3.5_0.5_14+1 into QFN.pretty
2019-03-15 Added footprint CONN-AMPHENOL-61083-101400LF with 3d models /modules/packages3d/3rd-party/amphenol/S61083-101x0xxx) into CONNECTOR.pretty
2019-03-15 Added footprint CONN-MOLEX-1053111206 with 3d models (modules/packages3d/3rd-party/molex/1053111206) into CONNECTOR_MOLEX.pretty
2019-03-15 Added footprint CONN-MOLEX-1053131206 with 3d models (modules/packages3d/3rd-party/molex/1053131206) into CONNECTOR_MOLEX.pretty
2019-03-15 Added footprint INDUCTOR-1008 into INDUCTOR.pretty
2019-03-15 Added footprint IDC-SAMTEC-SHF-110-01-L-D-SM-TR with 3d models (modules/packages3d/3rd-party/samtec/SHF-110-01-L-D-SM-TR) into CONNECTOR_IDC.pretty
2019-03-15 Added footprint INDUCTOR-WE-TPC-4828 with 3d models (modules/packages3d/3rd-party/wurth/WE-TPC-4828) into INDUCTOR.pretty
2019-03-15 Added footprint FUSE-1812 into FUSE.pretty
2019-03-15 Added footprint CONN-MOLEX-532530270 with 3d models (modules/packaged3d/3rd-party/molex/532530270) into CONNECTOR_MOLEX.pretty
2019-03-15 Added IDC-SAMTEC-SHF-105-01-L-D-SM-TR with 3d models (modules/packaged3d/3rd-party/samtec/SHF-105-01-L-D-SM-TR) into CONNECTOR_IDC.pretty
2019-03-15 Added footprint IDC-SAMTEC-SHF-106-01-L-D-SM-TR with 3d models (modules/packages3d/3rd-party/samtec/SHF-106-01-L-D-TH) into CONNECTOR_IDC.pretty
2019-03-15 Added footprint RESISTOR-CAT16-X8 into RESISTOR.pretty
2019-03-16 Added footprint STRIP_12x1_2.54-WE-61301211121 with 3d models (modules/packages3d/3rd-party/wurth/61301211121) into CONNECTOR.pretty
2019-03-19 Fixed symbol CAT16-330J8LF into nowae-resistor.lib
2019-03-20 Added footprint IDC-SAMTEC-SHF-105-01-L-D-SM-LC with 3d models (modules/packages3d/3rd-party/samtec/SHF-105-01-L-D-SM-LC) into CONNECTOR_IDC.pretty
2019-03-20 Added footprint IDC-SAMTEC-SHF-106-01-L-D-SM-LC with 3d models (modules/packages3d/3rd-party/samtec/SHF-106-01-L-D-SM-LC) into CONNECTOR_IDC.pretty
2019-03-25 Added footprint and 3d model of 6130xx11821 (05, 06, 07, 08, 09 and 10) by Wurth Elektronik
2019-03-25 Added +VDD schematic symbol
2019-03-26 Added footprint and 3d model of 5015 test-point by Keystone
2019-03-29 Added footprint DISPLAY-EA-OLEDM204 into DISPLAY.pretty
2019-04-05 Added symbol BUTTON-WE_434123025826 with description into nowae-switch.lib
2019-04-08 Fixed footprint BARRELJACK-WE-694106301002 into CONNECTOR.pretty
2019-04-08 Fixed footprint DIODE-SOD123 into DIODE.pretty
2019-04-09 Added different version of BGM111 module into wireless library
2019-04-09 Added 3d model and particolar footprint with only display (without connector) of OLED 48x64 by Raystar
2019-04-09 Added footprint for strip connector 5x1 and 7x1 2.54mm of pitch without connector
2019-04-09 Added a footprint for a different version of fiducial mark: it is 1mm copper and 2mm mask, but the mask is generated in a different way.
2019-04-10 Added schematic symbol for BGX13P22GA-V1 into wireless library. The footprint is just present
2019-04-10 Added schematic, footprint and 3d model of SAM-M8Q GPS module by U-Blox
2019-04-12 Fixed footprint CONN-MOLEX-1053131206 into CONNECTOR_MOLEX.pretty
2019-04-15 Footprint name fixing
2019-04-15 Silkscreen fix
2019-04-15 Added schemtic symbol for CMWX1ZZABZ-091 by Murata and AMW037 by Silicon Labs into wireless library
2019-04-18 Added CONN-HOLE_8x1_2.54 footprint
2019-04-19 Added footprint and 3d module of AMW037 by SiliconLabs
2019-07-23 Added footprint MICROSIP_3.80x3.00_0.6_10+1 with 3d modules (packages3d/3rd-party/texas/MICROSIP10-SIL0010A) into DFN.pretty
2019-08-17 Added parameters field for symbol into nowae-capacitor.lib
2019-08-17 Added symbol BZT52H-C9V1,115 with description into nowae-diode.lib
2019-08-17 Added symbol LMZM23601V5SIL with description into nowae-switching.lib Added description for TPS62153 into nowae-switching.lib
2019-08-20 Added footprint WSON_4.0x4.0_0.8_8+1 into SON.pretty
2019-08-20 Added footprint POWERSSO-16_4.9x3.9_0.5 into SOIC.pretty
2019-08-20 Fixed footprint POWERSSO-16_4.9x3.9_0.5_16+1 into SOIC.pretty
2019-08-21 Added footprint INDUCTOR-BOURNS-SRN6045 with 3d models (/3rd-party/bourns) into INDUCTOR.pretty
2019-08-23 Added footprint association for ES1CL into nowae-diode.lib
2019-08-26 Added footprint SDCARD-HIROSE-DM3AT into CONNECTOR.pretty
2019-08-26 Renamed footprint TRANSFORMER-WURTH-750315371 into INDUCTOR.pretty
2019-08-26 Added footprints TRANSFORMER-WURTH-750316029 and TRANSFORMER-WURTH-760390015 into INDUCTOR.pretty
2019-08-26 Added footprint DSUB9-F-V-WURTH-61800929321 into CONNECTOR_DSUB.pretty
2019-08-26 Added footprint HSSOP24_7.8x4.4_0.65 into SOP.pretty
2019-08-26 Added footprint DIODE-POWERDI123 into DIODE.pretty
2019-08-27 Added 3d models POWERDI123 into packages3d/3rd-party/diodes. Fixed footprint DIODE-POWERDI123 into DIODE.pretty
2019-08-27 Added footprint TRANSFORMER-COILTRONICS-VPH4-0060-R into INDUCTOR.pretty
2019-08-30 Added 3d models 0603 into packages3d/nowae/RESISTOR Modified footprint RESISTOR-0603 into RESISTOR.pretty
2019-08-30 Added footprint SSOP16_4.4x10.3_1.27 with 3d models (modules/packages3d/3rd-party/texas/SSOP16-NS) into SOP.pretty
2019-08-30 Added footprint SSOP28_5.3x10.3_0.65 with 3d models (modules/packages3d/3rd-party/texas/SSOP28-DB) into SOP.pretty
2019-08-30 Modified footprint CONN-HRS-DF40C-80DS-0.4V(51) into CONNECTOR.pretty Fixed 3d models DF40C-80DS-0.4V(51) into modules/packages3d/3rd-party/hirose
2019-08-30 Added footprint WE-PDA-1280 with 3d models (modules/packages3d/3rd-party/wurth/WE-PDA-1280) into INDUCTOR.pretty
2019-08-30 Modified footprint USB-3.0-A-WURTH-692141030100 into CONNECTOR.pretty Modifies 3d models 692141030100 into modules/packages3d/3rd-party/wurth
2019-08-31 Added footprint FUSE-1206 with 3d models (modules/packages3d/3rd-party/nowae/FUSE-1206) into FUSE.pretty
2019-08-31 Renamed FUSE-1206 3d models
2019-08-31 Fixed FUSE-1206 into FUSE.pretty
2019-08-31 Modified footprint DSUB9-F-V-WURTH-61800929321 into CONNECTOR.pretty and updated 3d models 61800929321 into modules/packages3d/3rd-party/wurth/
2019-08-31 Modified footprint CAPACITOR-0603 into CAPACITOR.pretty
2019-08-31 Added footprint CONN-S311-V-2-5.08 with 3d models (modules/packages3d/3rd-party/wurth/6911311500102,691351500002) into CONNECTOR.pretty with
2019-09-01 Added symbol CONN_6X2 into nowae-connector.lib
2019-09-02 Added symbol SMCJ26A-TR with description into nowae-diode.lib
2019-09-03 Added footprint CAPACITOR-1812 with 3d models (modules/packages3d/nowae/CAPACITOR/1812) into CAPACITOR.pretty
2019-09-03 Modified footprint CAPACITOR-1210 into CAPACITOR.pretty Added 3d models 1210 into modules/packages3d/nowae/CAPACITOR
2019-09-03 Modified footprint INDUCTOR-1206 into INDUCTOR.pretty Added 3d models WE-CBF-1206 into modules/packages3d/3rd-party/wurth
2019-09-11 Added footprint SDCARD-MOLEX-472192001 with 3d models (modules/packages3d/3rd-party/wurth/472192001) into CONNECTOR.pretty
2019-09-11 Added footprint CONN-STRIP-4x2-2.54 with 3d models (modules/packages3d/3rd-party/wurth/61300821121) into CONNECTOR.pretty
2019-09-12 Modified footprint USB-WURTH-61400413321 into CONNECTOR.pretty
2019-09-18 Modified symbol TLV1117-50CDCY into nowae-regulator.lib
2019-09-18 Added symbol RGB-WE-SFTW-150141M173100 with description into nowae-led.lib
2019-09-25 Modified symbol WPMDL1201801 into nowae-switching.lib
2019-09-27 Added symbol CONN_3X2 with description into nowae-connector.lib
2019-10-02 Added symbols 1SMB5929BT3G, BYS10-45-E3-TR and DFLS230LH-7 with descriptions into nowae-diode.lib
2019-10-02 Fixed leds symbol into nowae-led.lib
2019-10-02 Fixed symbol WPMDL1201801 into nowae-switching.lib
2019-10-02 Fixed ground symbols into power.lib
2019-10-03 Added footprint library CONNECTOR_DINKLE.pretty
2019-10-03 Added 3d models for 0603 designed by nowae into modules/packages3d/nowae/CAPACITOR and RESISTOR
2019-10-03 Added footprint LEDRGB-WE-3258 into LEDs.pretty
2019-10-03 Added footprint CRYSTAL-0805 into CRYSTAL.pretty
2019-10-03 Modified and renamed HDMI-WE-685119134923 into CONNECTOR.pretty
2019-10-03 Added footprint INDUCTOR-WE-CFWI-1312 into INDUCTOR.pretty
2019-10-03 Added footprint INDUCTOR-WE-LQS-6045 into INDUCTOR.pretty
2019-10-03 Added footprint INDUCTOR-WE-MTCI-5030 into INDUCTOR.pretty
2019-10-03 Added footprint BUTTON-WE-434123025826 into BUTTON.pretty
2019-10-03 Renamed IDC-SAMTEC-SHF-105-01-L-D-SM into CONNECTOR_IDC.pretty
2019-10-03 Added footprint IDC-SAMTEC-SHF-106-01-L-D-TH into CONNECTOR_IDC.pretty
2019-10-08 Fixed footprints into CONNECTOR_DINKLE.pretty
2019-10-08 Fixed symbol DB9_FEMALE into nowae-connector.lib
2019-10-08 Fixed footprint M2 connectors into CONNECTOR.pretty
2019-10-14 Modified footprints into CONNECTOR_DINKLE.pretty Added 3d models for Dinkle connectors
2019-10-18 Updated ETHERNET-WURTH-74990101210 into CONNECTOR.pretty Added 3d modules for 74990101210 into modules/packages3d/3rd-party/wurth
2019-10-18 Modified footprint LQFP144_20x20_0.5 into LQFP.pretty Added 3d models LQFP144-PGE into modules/packages/3rd-party/texas
2019-10-18 Fixed footprint LQFP144_20x20_0.5 into LQFP.pretty
2019-10-23 Added symbol STM32G031K8T6 with description into nowae-microcontroller.lib
2019-11-05 Modified symbol CAPACITOR into nowae-capacitor.lib
2019-11-05 Added symbol ESP32-WROOM-32D into nowae-wireless.lib
2019-11-05 Added symbol CAT16-103J8LF into nowae-resistor.lib Fixed symbol RESISTOR into nowae-resistor.lib
2019-11-05 Added symbol AP2114H-3.3TRG1 with description into nowae-regulator.lib
2019-11-05 Added symbol PMEG2010ER,115 with description into nowae-diode.lib
2019-11-05 Added symbol BUTTON-WE-434123025826 into nowae-switch.lib
2019-11-05 Fixed symbol into nowae-connector.lib and nowae-transistor.lib
2019-11-05 Added footprint TSSOP20_4.4x6.5_0.65 with 3d models (modules/packages3d/3rd-party/texas/TSSOP20-PW) into SOP.pretty
2019-11-05 Added footprint ESP32-WROOM-32D into WIFI.pretty
2020-01-18 Added footprint INDUCTOR-WE-MAPI-3020 with 3d models (modules/packages3d/3rd-party/wurth) into INDUCTOR.pretty
2020-01-18 Fixed footprint into INDUCTOR.pretty
2020-01-18 Added footprint CONN_WE-S2143-H-2-3.81 with 3d models (modules/packages3d/3rd-party/wurth) into CONNECTOR_WR-TBL.pretty
2020-01-18 Added footprint CONN_WE-S2143-H-3-3.81 with 3d models (/modules/packages3d/3rd-party/wurth) into CONNECTOR_WR-TBL.pretty
2020-01-19 Fixed footprints into CRYSTAL.pretty
2020-01-19 Added footprint CRYSTAL_WE-IQXC-42 into CRYSTAL.pretty
2020-01-30 Added footprints SPACER_M2.5x5_WE-9774050151 with 3d models (modules/packages3rd/3rd-party/wurth/9774050151) into MECHANICAL.pretty
2020-02-02 Added symbols STEF05DPUR, STEF12PUR and TPS25944LRVCR with descriptions into nowae-fuse.lib (issue #21) Added footprints DFN10_3.0x3.0_0.5 into DFN.pretty and WQFN20_3.0x4.0_0.5_20+1 with 3d models (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
2020-02-02 Added symbol of WR-TBL Serie 2109 into CONNECTOR_WR-TBL.pretty
2020-02-02 Added footprint LEDRGB-WE-150066M153000 into LEDs.pretty
2020-02-02 Added footprint IDC_08x02-2.54_WE-WR-BHD-61201622021 with 3d models (modules/packages3d/3rd-party/wurth/61201622021) into CONNECTOR_IDC.pretty
2020-02-02 Fixed footprints attibute
2020-02-02 Added footprint USB3.1-C_WE-632723300011 with 3d models (modules/packages3d/3rd-party/wurth/632723300011) into CONNECTOR.pretty
2020-02-02 Added symbol USB3.1-C-WE-632723300011 with description into nowae-connector.lib
2020-02-02 Added symbols ESDA25P35-1U1M and ESDA25W with description into nowae-diode.lib
2020-02-02 Added symbol LED-RGB-WE-150066M153000 with description into nowae-led.lib
2020-02-02 Fixed nowae-capacitor.lib
2020-02-09 Added symbol WHITE-WE-SWTP-158563427 with description into nowae-led.lib
2020-02-18 Added footprint WSON12_4.0x4.0_0.5_12+1 with 3d models (modules/packages3d/3rd-party/texas/WSON12-DNT) into SON.pretty
2020-02-18 Fixed symbol BUTTON-WE-434123025826 into nowae-switch.lib
2020-02-19 Updated footprint WSON12_4.0x4.0_0.5_12+1 into SON.pretty.
2020-03-21 Added footprint INDUCTOR_WE-XHMI-6030 and INDUCTOR_WE-XHMI-6060 into INDUCTOR.pretty
2020-05-11 Added symbols ISL9238HRTZ-T7A and STBC08PMR with descriptions into nowae-batterycharger.lib
2020-06-08 Added symbol MINIPCIE into nowae-connector.lib
2020-06-08 Added symbol STPS340U with description into nowae-diode.lib
2020-06-08 Added symbols STUSB4500LQTR and STUSB4500QTR with description into nowae-driver.lib
2020-06-08 Modified symbol AP2114H-3.3TRG1 into nowae-regulator.lib
2020-06-08 Added symbol LSM6DSOXTR with description into nowae-sensor.lib
2020-06-08 Added symbol TLV70215DBVR with description into nowae-regulator.lib Modified symbol TLV70218DBV into nowae-regulator.lib
2020-06-08 Added symbol +1.5V into power.lib
2020-06-15 Added symbol TPD1E10B09DPYR with description into nowae-diode.lib
2020-06-15 Added symbols LTC3588EMSE-1#PBF and ST1S50PUR with descriptions into nowae-switching.lib
2020-06-15 Added symbol LTC2955CTS8-1 with description into nowae-switch.lib
2020-06-16 Added symbol STM32WB55RCV6 with description into nowae-microcontroller.lib
2020-06-16 Added symbol MICROSIM-WURTH-693023010811 with description into nowae-connector.lib
2020-06-17 Added footprint INDUCTOR_WE-HCI-1365 with 3d models (packages3d/3rd-party/wurth/WE-HCI-1365) into INDUCTOR.pretty
2020-06-17 Added footprint INDUCTOR_WE-PD-1260 with 3d models (packages3d/3rd-party/wurth/WE-PD-1260) into INDUCTOR.pretty
2020-06-17 Added footprint TSOT23-8 into SOT.pretty
2020-06-17 Added symbol +10V into power.lib
2020-06-17 Added symbol ST730MR with description into nowae-regulator.lib
2020-06-17 Added symbol CONN_24X1 into nowae-connector.lib
2020-06-24 Added footprint X2QFN10_1.5x2.0_0.5 into QFN.pretty
2020-06-24 Added footprint X2QFN12_1.6x1.6_0.4 into QFN.pretty
2020-06-24 Added footprint WLCSP12_1.65x1.35_0.4 into BGA.pretty
2020-06-24 Added footprint QFN1610 into QFN.pretty
2020-06-24 Added footprint POWERSSO12_4.9x3.9_0.8_12+1 into SOIC.pretty
2020-06-24 Added footprint TDSON8_3.2x3.2_0.65 into SON.pretty
2020-06-24 Added footprint VFQFPN20_3x3_0.4_20+1 into QFN.pretty
2020-06-24 Added footprint VFQFPN32_5x5_0.5_32+1 into QFN.pretty
2020-06-24 Added footprint ZIF-WURTH-686114148922 with 3d models (/packages3d/3rd-party/wurth/686114148922) into CONNECTOR_ZIF.pretty
2020-06-24 Added footprint ZIF-WURTH-687124149022 with 3d models (packages3d/3rd-party/wurth/687124149022) into CONNECTOR_ZIF.pretty
2020-06-24 Added footprint BUTTON_WE-TATU-431256083736 with 3d models (packages3d/3rd-party/wurth/WE-TATU-431256083736) into BUTTON.pretty
2020-06-26 Added footprint ZIF_WE-FPC-687124183622 with 3d models (packages3d/3rd-party/wurth/WR-FPC-687124183622) into CONNECTOR_ZIF.pretty
2020-06-30 Modified symbol ISL9238HRTZ-T7A into nowae-batterycharger.lib
2020-09-24 Added schematic symbol of STM32L073CBT6
2020-09-25 Added schematic symbol of TCA9554PWR Fix text dimension.
2020-09-25 Added schematic symbol of USB-C connector 632722110112 by Wurth Elektronic
2020-09-25 Added footprint and 3d model of connector 632722110112 by Wurth Elektronik
2020-09-28 Fix pin and text dimensions
2020-10-07 Added schematic, footprint and 3d model of white LEDs 158301250 by Wurth Elektronik
2020-10-08 Added footprint for: * Fiducial mark 1mm copper, 3mm clearance * SMD testpoint 1.5mm and 2mm
2020-11-17 Added symbol +15V and -15V into power.lib
2020-11-17 Added symbol SMAJ36CA with description into nowae-diode.lib
2020-11-18 Added symbol ADG442BRZ with description into nowae-switch.lib
2020-11-18 Added symbol +1.8VISO with description into power.lib
2020-11-18 Added symbol MCP1824T-1802E_DC with description into nowae-regulator.lib
2020-11-18 Fixed symbol ISL9238HRTZ-T7A into nowae-batterycharger.lib
2020-11-20 Added symbol TPD2EUSB30DRTR, TPD4E05U06DQAR with description into nowae-diode.lib
2020-11-20 Added symbol TPS2051BDBVR with description nowae-switch.lib
2020-11-20 Added symbol M.2_KEY-B, M.2_KEY-E, M.2_KEY-M and USB-3.0-A-WURTH-692141030100 into nowae-connectors.lib
2020-11-24 Added footprint field for symbol DSC1123CI2-125.0000 into nowae-crystal.lib. Added footprint field for symbols TEN3-2411N, TEN40-2411N, TOS10-05SIL, TSR1-2433 into nowae-dcdc.lib.
2020-11-24 Added symbol ST1S10PUR with description into nowae-switching.lib
2020-11-24 Added footprint DFN8_4.0x4.0_0.8 into DFN.pretty. Added footprint SIP3-THT into SIP.pretty. Added footprint SOT223-5 into SOT.pretty. Added footprints TRACO-TEN40N-XXXX and TRACO-TOS10-XXSIL into TRA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
2020-11-25 Renamed footprint POWERSO36_11.0x15.9_0.65.kicad_mod into SOIC.pretty
2020-11-25 Renamed footprint POWERSSO16_4.9x3.9_0.5_16+1.kicad_mod into SOIC.pretty
2020-11-25 Renamed footprint POWERSO10_7.5x9.4_1.27.kicad_mod into SOIC.pretty
2020-11-25 Added footprint USB-3.0-A-WURTH-692121430000 with 3d models (modules/packages3d/3rd-party/692121430000) into CONNECTOR.pretty
2020-11-26 Added footprin CONN-S3233-V-2-3.81 with 3d models (modules/packages3d/3rd-party/wurth/691323300002) into CONNECTOR_WR-TBL.pretty
2020-12-01 Added footprint DFN10_3.0x3.0_0.5 into DFN.pretty
2020-12-02 Added footprint CONN-S321-V-2-3.81 with 3d models (modules/packages3d/3rd-party/wurth/691321300002) into CONNECTOR_WR-TBL.pretty
2020-12-02 Added footprint CONN-S321-V-6-3.81 with 3d models (modules/packages3d/3rd-party/wurth/691321300006) into CONNECTOR_WR-TBL.pretty
2020-12-02 Added footprint CONN-S321-V-8-3.81 with 3d models (modules/packages3d/3rd-party/wurth/691321300008) into CONNECTOR_WR-TBL.pretty
2020-12-02 Modified footprint TRACO-TEN40N-XXXX into TRACOPOWER.pretty Added 3d modules TEN40N into modules/packages3d/3rd-party/traco
2020-12-02 Fixed footprint TRACO-TOS10-XXSIL into TRACOPOWER.pretty
2020-12-02 Renamed footprint TRACO-TOS10-XXSIL into modules/TRACOPOWER.pretty
2020-12-02 Modified footprint TRACO-TOS10-05SIL into modules/TRACOPOWER.pretty
2020-12-02 Added footprint TSSOP24_4.4x7.8_0.65_24+1 into SOP.pretty
2020-12-02 Added footprint TRACO-THM20 with 3d modules (modules/packages3d/3rd-party/traco/THM20) into TRACOPOWER.pretty
2020-12-02 Fixed footprint SOT223-5 into SOT.pretty
2020-12-02 Fixed footprint IDC-7x2-2.54-WE-61201421621 into CONNECTOR_IDC.pretty
2020-12-02 Modified footprints CONN-S321-V-2-3.81, CONN-S321-V-6-3.81, CONN-S321-V-8-3.81, CONN-S3233-V-2-3.81 into CONNECTOR_WR-TBL.pretty Added 3d modules 6911361300002, 6911361300006, 6911361300008, 69113643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
2020-12-02 Fixed symbol MICROSD-WURTH-693071010811 into nowae-connector.lib
2020-12-09 Swapped pin for diode footprints into DIODE.pretty
2020-12-09 Modified F.Fab and F.SilkS layers for some diodes into DIODE.pretty
2020-12-21 Added footprint CONN-S321-V-9-3.81 with 3d models (modules/packages3d/3rd-party/wurth/691321300009 and modules/packages3d/3rd-party/wurth/691361300009) into CONNECTOR_WR-TBL.pretty
2021-03-11 Added 61304021821 by Wurth Elektronik footprint
2021-03-16 Added schematic, footprint and 3d model of POLOLU-2130
2021-03-16 Small fix on ESP32 module
2021-03-16 Added footprint and 3d model of MPT 0,5/ 2-2,54 by Phoenix
2021-03-19 Changed 3d model of ESP32-WROOM-32D
2021-03-19 Added footprint and 3d model of POLOLU-2868
2021-03-19 Added schematic symbol of DMP2120U-7 by Diodes
2021-03-19 Added schematic symbol of POLOLU-2868
2021-03-20 Added footprint and 3d model of 450405020524 by Wurth Elektronik.
2021-03-20 Schematic symbol of 450405020524 by Wurth Elektronik
2021-03-21 Power text dimension
2021-03-21 Added schematic, footprint and 3d of 155124M173200 LED RGB by Wurth Elektronik.
2021-03-25 Added footprint and 3d model of button 430162073826 by Wurth Elektronik
2021-03-26 Added schematic symbol of button 430162073826 by Wurth Elektronik
2021-03-26 fix text and pin dimensions.
2021-04-01 Added footprint and 3d of 61001611921 by Wurth Elektronik
2021-04-06 Added new footprint type for SMD jumper
2021-04-07 Fixed pin number.
2021-10-05 Fixed footprint SOIC16_3.9x9.9_1.27 into SOIC.pretty Added files SOIC16-D.step and SOIC16-D.wrl into modules/packages3d/3rd-party/texas
2021-10-28 Added symbol MINIUSB-B-WURTH-651005136421 into nowae-connector.lib
2021-11-05 Added symbol LDK130C15R with description into nowae-regulator.lib
2021-11-05 Added symbol STMPS2171MTR with description into nowae-switch.lib
2021-11-11 Fixed symbol WE-TVS-82400102 into nowae-diode.lib
2021-11-11 Renamed symbol from USB-A-90-WURTH-61400416021 to USB-A-90-WE-61400416021 into nowae-connector.lib
2021-11-11 Fixed footprint MICROSIP_3.80x3.00_0.6_10+1 into DFN.pretty
2021-11-11 Fixed footprint DIALIGHT-SINGLE_3.56MM-5151049F into MECHANICAL.pretty
2021-11-11 Fixed footprint BUTTON_WE-TATU-431256083736 into BUTTON.pretty
2023-07-04 Added 3d models for Wurth_MagI3C-VDMM_LGA-6_3.2x2.5mm
    [Download_STP_171960501 (rev1).stp]
2023-07-04 Added 3d models for ESP32_C3_MINI_1
